abinash18/KBUltra/ControlCardRP/Hardware/Rev1/ControlCardRP/_restore_backup_2026-08-10T23-14-51-235/Production/ordering_instructions.txt

Ordering Instructions:
Panel dimensions: 68.10 x 63.14 mm.
Solder Mask: Red (Default)
Silkscreen: White (Default)
Layers: 4
Finish: HASL Lead-free (Default)
Thickness: 1.6mm (Default)
Copper weight: 1oz (Default)
Minimum track width: 0.12mm (4.72mil)
Minimum via drill: 0.20mm (7.87mil)
