abinash18/KBUltra/Hardware/PCB/Mk1/Rev1/KBUltraMk1/KBUltraMk1.kicad_pcb

## KiCad design Hardware/PCB/Mk1/Rev1/KBUltraMk1/KBUltraMk1.kicad_pcb (2026-09-08)

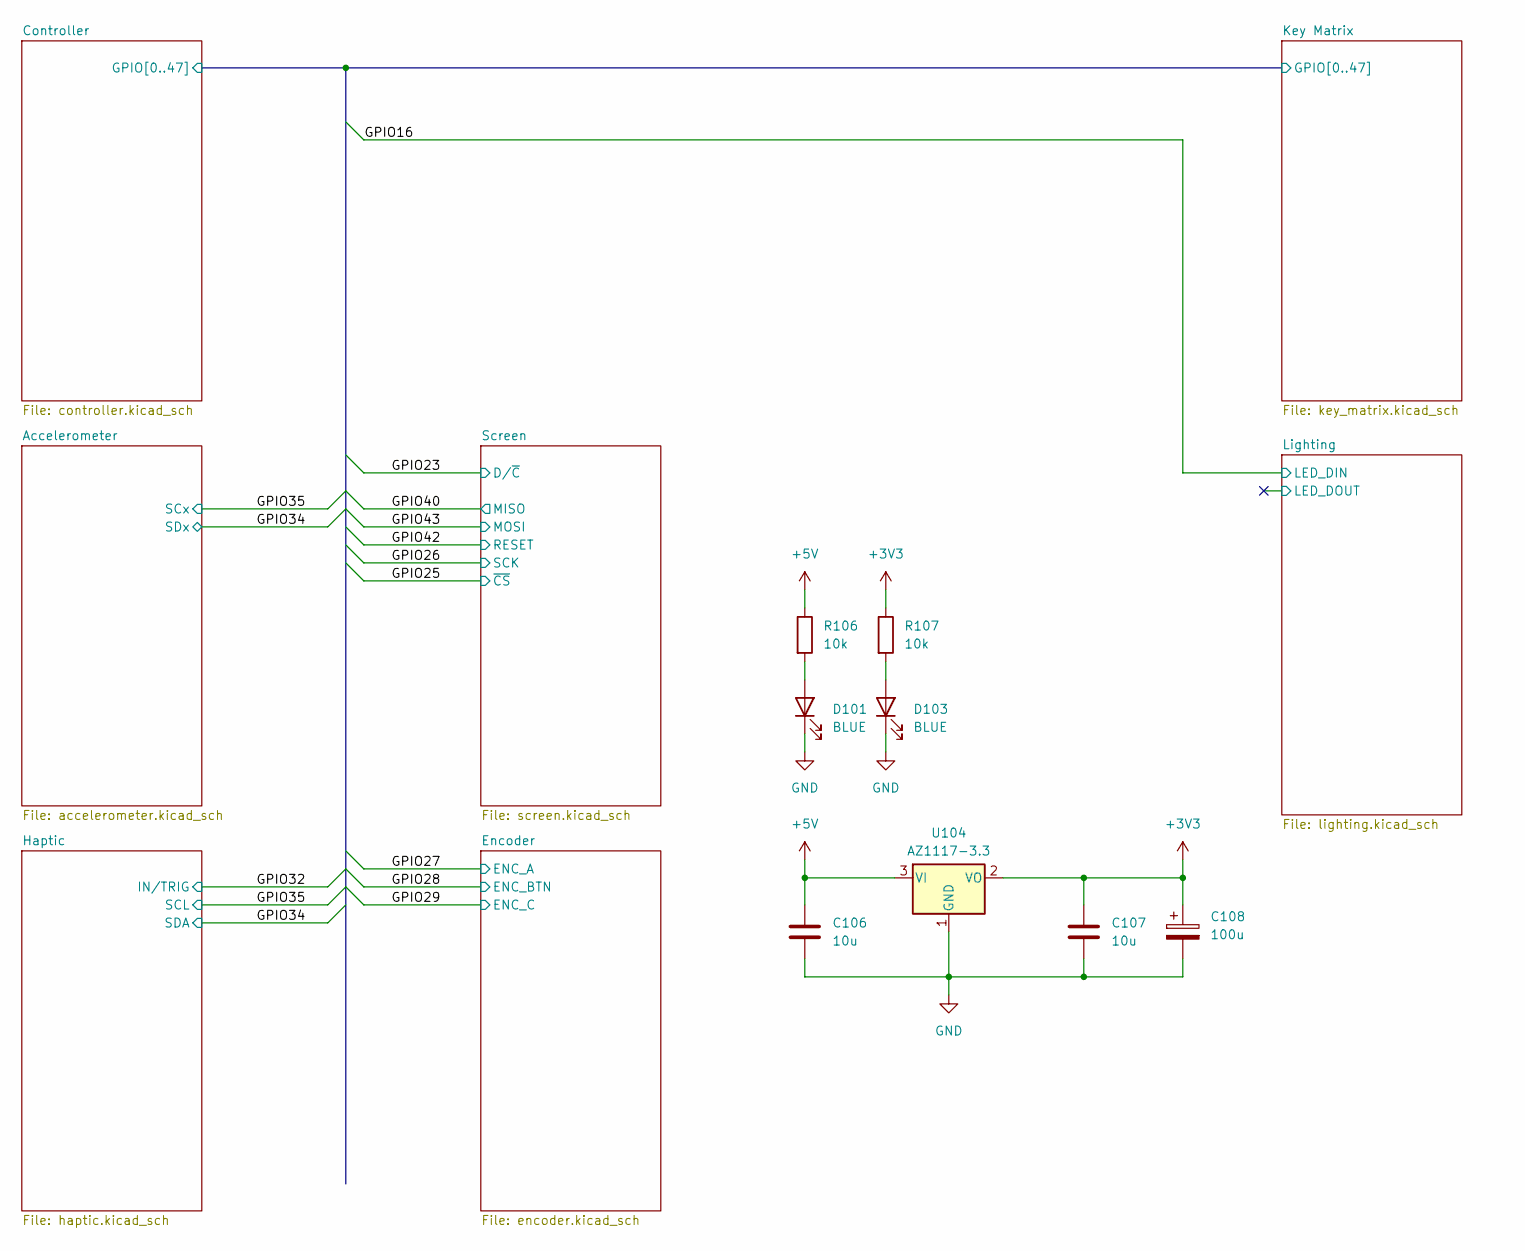
[picture p1: schematic KBUltraMk1.kicad_sch]

Parts:
C106, C107: 10u; C_0603_1608Metric; JLC Part# C96446
C108: 100u; CP_EIA-3528-21_Kemet-B_HandSolder; JLC Part# C16133
D101, D103: BLUE; LED_0603_1608Metric
R106, R107: 10k; R_0603_1608Metric; JLC Part# C25804
U104: AZ1117-3.3; SOT-223-3_TabPin2

Connections:
+3V3: C107.2, C108.1, R107.1, U104.2 (VO); also elsewhere on the board
+5V: C106.2, R106.1, U104.3 (VI); also elsewhere on the board
GND: C106.1, C107.1, C108.2, D101.1 (K), D103.1 (K), U104.1 (GND); also elsewhere on the board
unnamed: D101.2 (A), R106.2
unnamed: D103.2 (A), R107.2

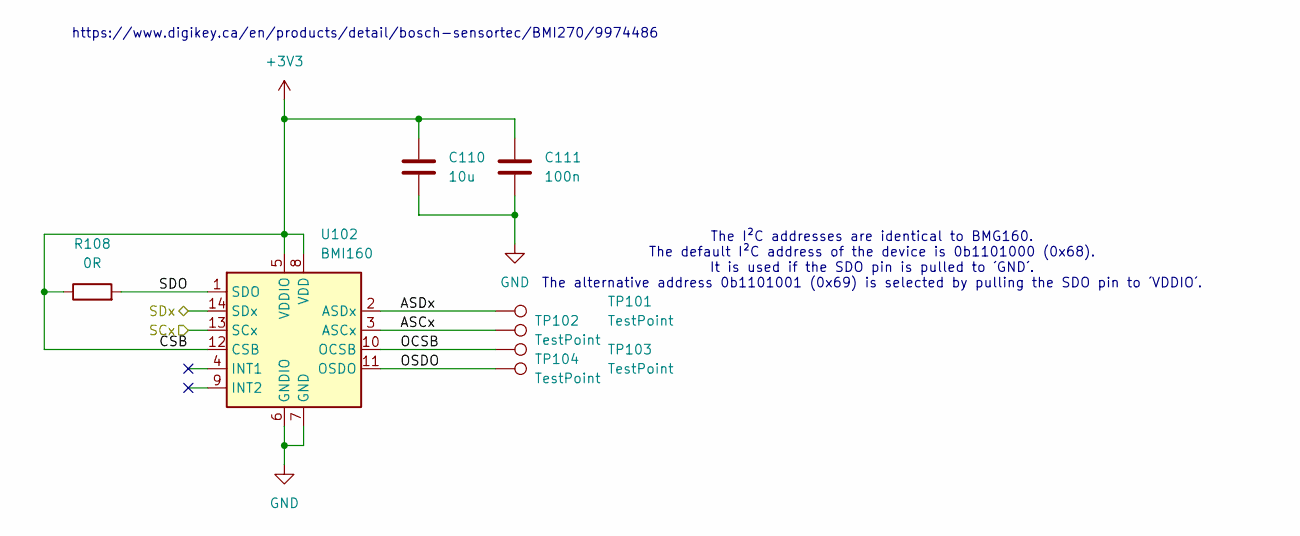
[picture p2: schematic accelerometer.kicad_sch]

Parts:
C110: 10u; C_0603_1608Metric; JLC Part# C96446
C111: 100n; C_0603_1608Metric; JLC Part# C14663
R108: 0R; R_0603_1608Metric; JLC Part# C21189
TP101, TP102, TP103, TP104: TestPoint; TestPoint_Pad_D1.0mm
U102: BMI160; Bosch_LGA-14_3x2.5mm_P0.5mm

Connections:
+3V3: C110.1, C111.1, R108.1, U102.5 (VDDIO), U102.8 (VDD), U102.12 (CSB); also elsewhere on the board
/Accelerometer/ASCx: TP102.1 (1_1), U102.3 (ASCx)
/Accelerometer/ASDx: TP101.1 (1_1), U102.2 (ASDx)
/Accelerometer/OCSB: TP103.1 (1_1), U102.10 (OCSB)
/Accelerometer/OSDO: TP104.1 (1_1), U102.11 (OSDO)
/Accelerometer/SDO: R108.2, U102.1 (SDO)
/Controller/GPIO34: U102.14 (SDx); also elsewhere on the board
/Controller/GPIO35: U102.13 (SCx); also elsewhere on the board
GND: C110.2, C111.2, U102.6 (GNDIO), U102.7 (GND); also elsewhere on the board

Notes on the sheet:
The I²C addresses are identical to BMG160. The default I²C address of the device is 0b1101000 (0x68). It is used if the SDO pin is pulled to ´GND´. The alternative address 0b1101001 (0x69) is selected by pulling the SDO pin to ´VDDIO´.
https://www.digikey.ca/en/products/detail/bosch-sensortec/BMI270/9974486

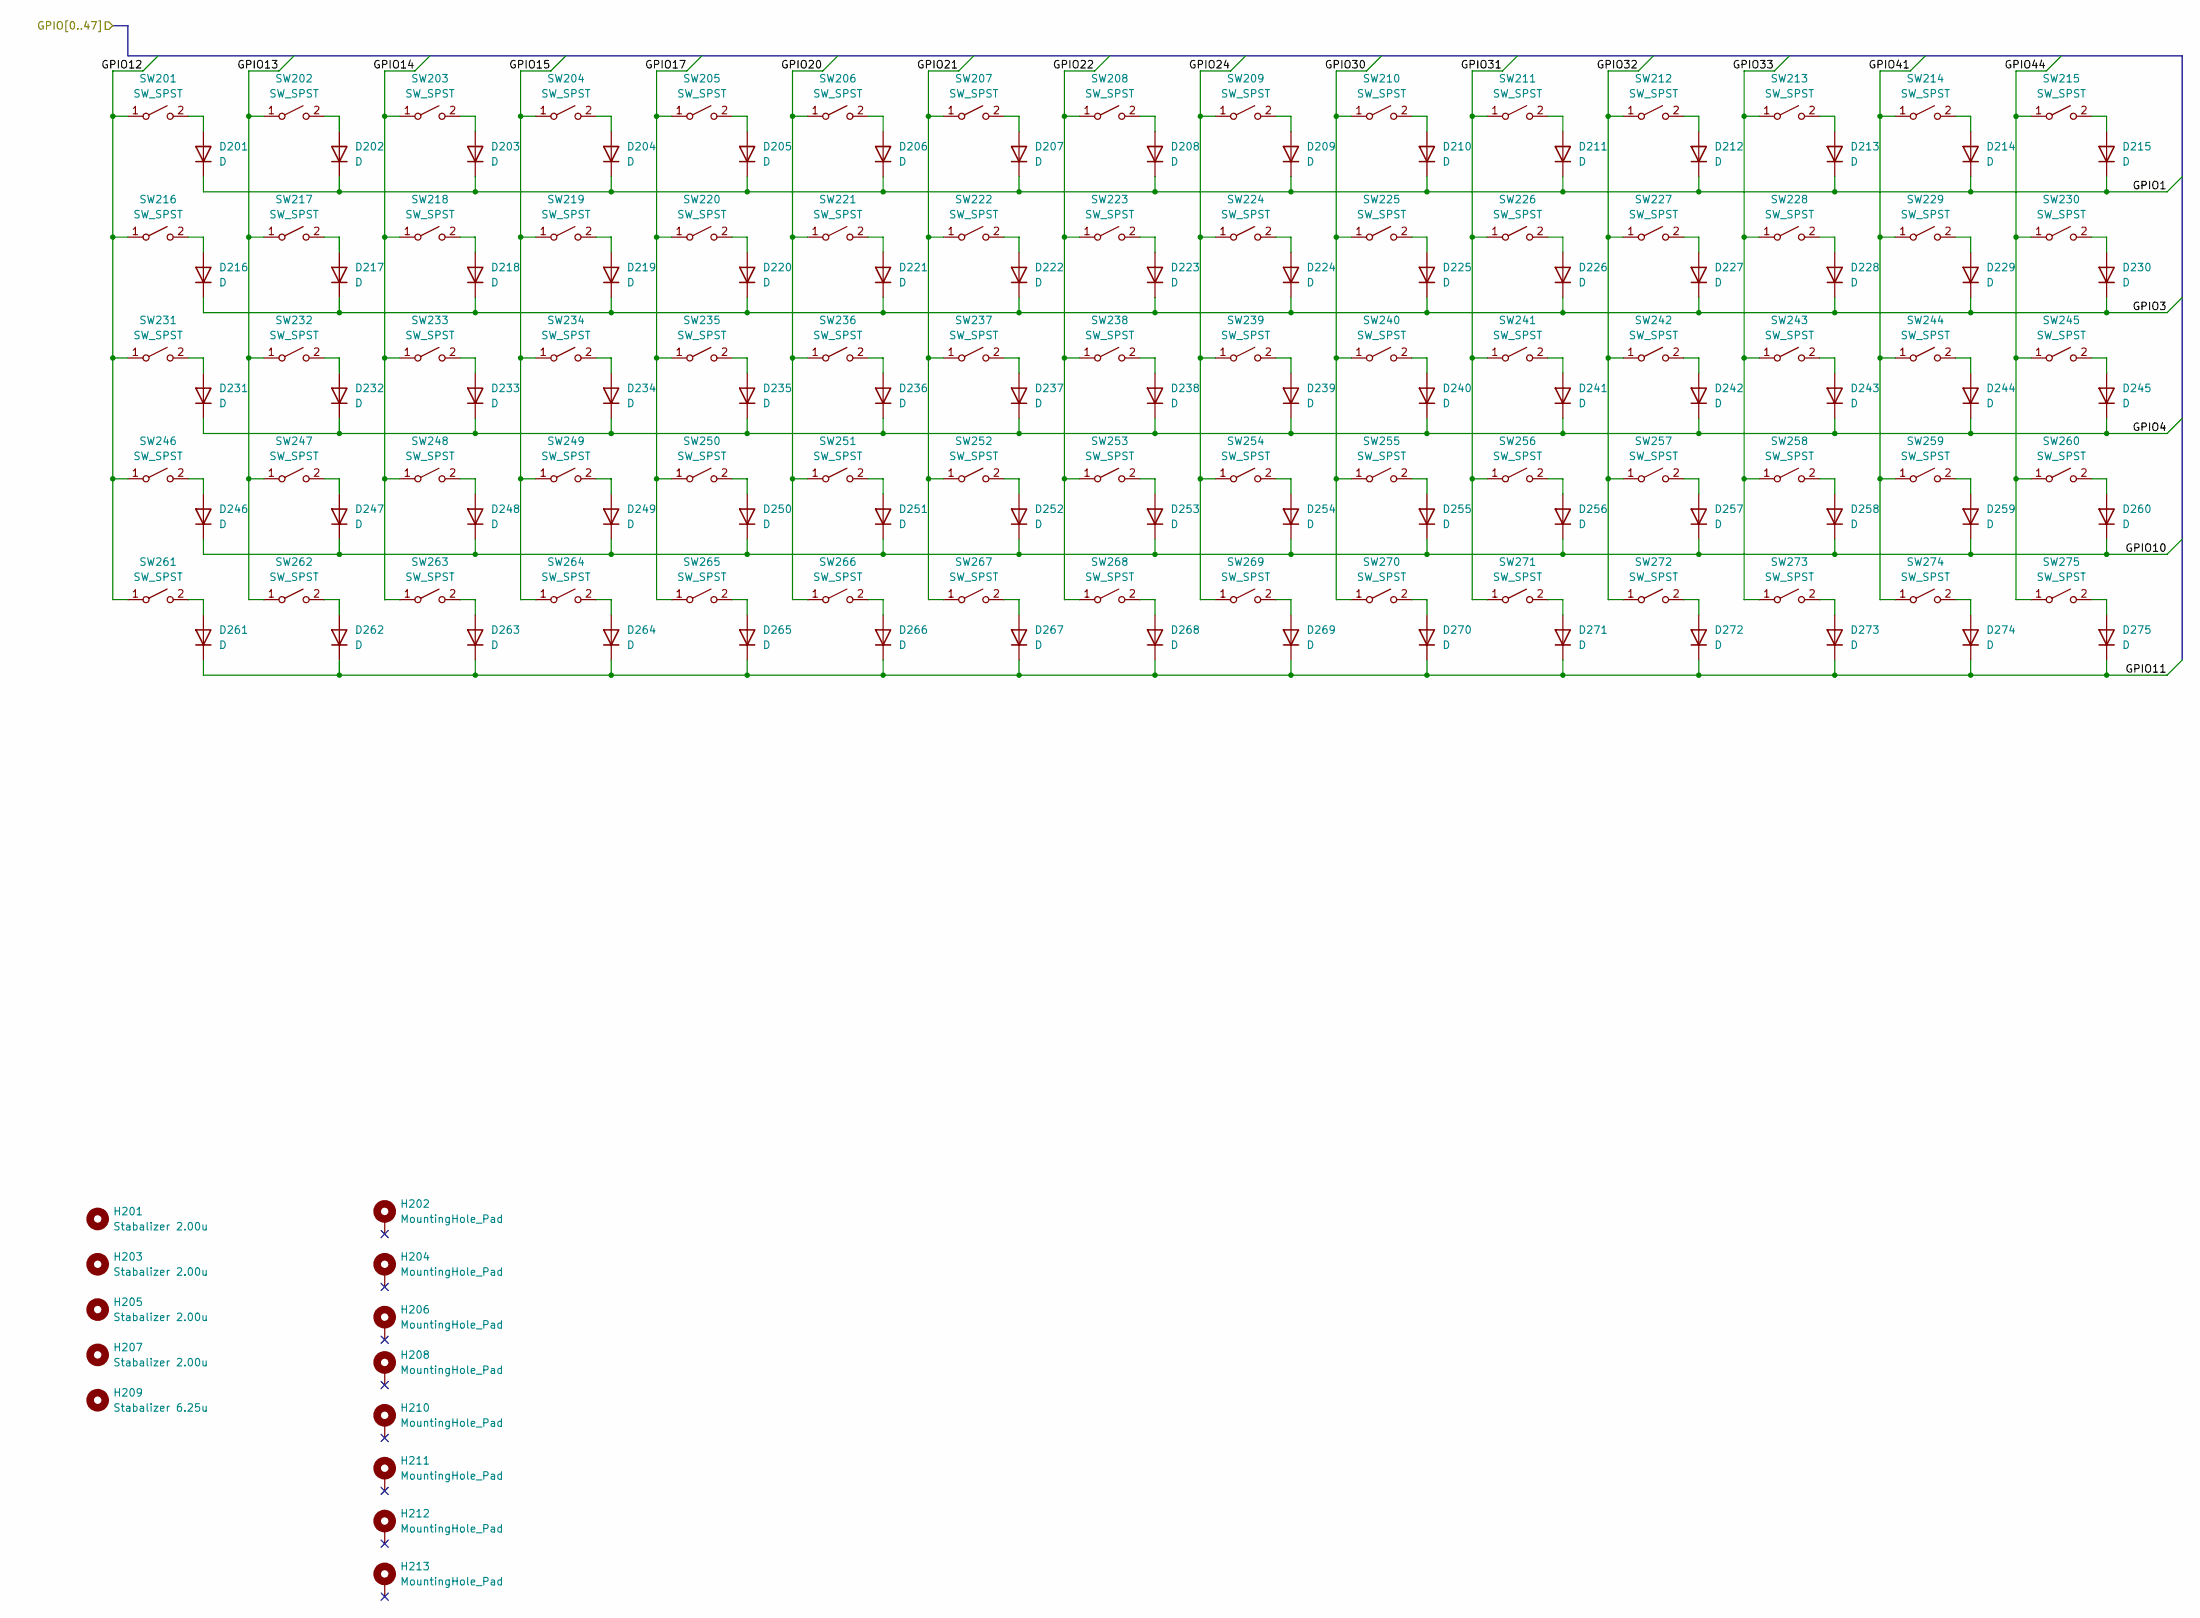
[picture p3: schematic key_matrix.kicad_sch]

Parts:
D201, D202, D203, D204, D205, D206, D207, D208, D209, D210, D211, D212, D213, D214, D215, D216, D217, D218, D219, D220, D221, D222, D223, D224, D225, D226, D227, D228, D229, D230, D231, D232, D233, D234, D235, D236, D237, D238, D239, D240, D241, D242, D243, D244, D245, D246, D247, D248, D249, D250, D251, D252, D253, D254, D255, D256, D257, D258, D259, D260, D261, D262, D263, D264, D265, D266, D267, D268, D269, D270, D271, D272, D273, D274, D275: D; D_SOD-123; JLC Part# C81598
H201, H203, H205, H207: Stabalizer 2.00u; Stabilizer_Cherry_MX_2.00u
H202, H204, H206, H208, H210, H211, H212, H213: MountingHole_Pad; MountingHole_3.2mm_M3_Pad_Via
H209: Stabalizer 6.25u; Stabilizer_Cherry_MX_6.25u
SW201, SW202, SW203, SW204, SW205, SW206, SW207, SW208, SW209, SW210, SW211, SW212, SW213, SW214, SW215, SW216, SW217, SW218, SW219, SW220, SW221, SW222, SW223, SW224, SW226, SW228, SW229, SW230, SW231, SW232, SW233, SW234, SW235, SW236, SW237, SW238, SW239, SW241, SW243, SW244, SW245, SW246, SW247, SW248, SW249, SW250, SW251, SW252, SW253, SW255, SW257, SW258, SW259, SW260, SW261, SW262, SW263, SW264, SW265, SW266: SW_SPST; SW_Hotswap_Kailh_MX_Plated_1.00u; JLC Part# C41430893
SW225: SW_SPST; SW_Hotswap_Kailh_MX_Plated_2.00u; JLC Part# C41430893
SW227, SW240: SW_SPST; SW_Hotswap_Kailh_MX_Plated_1.50u; JLC Part# C41430893
SW242: SW_SPST; SW_Hotswap_Kailh_MX_Plated_1.75u; JLC Part# C41430893
SW254, SW256: SW_SPST; SW_Hotswap_Kailh_MX_Plated_2.25u; JLC Part# C41430893
SW267: SW_SPST; SW_Hotswap_Kailh_MX_Plated_2.75u; JLC Part# C41430893
SW268, SW269, SW270, SW272, SW273, SW274, SW275: SW_SPST; SW_Hotswap_Kailh_MX_Plated_1.25u; JLC Part# C41430893
SW271: SW_SPST; SW_Hotswap_Kailh_MX_Plated_6.25u; JLC Part# C41430893

Connections:
/Controller/GPIO1: D201.1 (K), D202.1 (K), D203.1 (K), D204.1 (K), D205.1 (K), D206.1 (K), D207.1 (K), D208.1 (K), D209.1 (K), D210.1 (K), D211.1 (K), D212.1 (K), D213.1 (K), D214.1 (K), D215.1 (K); also elsewhere on the board
/Controller/GPIO3: D216.1 (K), D217.1 (K), D218.1 (K), D219.1 (K), D220.1 (K), D221.1 (K), D222.1 (K), D223.1 (K), D224.1 (K), D225.1 (K), D226.1 (K), D227.1 (K), D228.1 (K), D229.1 (K), D230.1 (K); also elsewhere on the board
/Controller/GPIO4: D231.1 (K), D232.1 (K), D233.1 (K), D234.1 (K), D235.1 (K), D236.1 (K), D237.1 (K), D238.1 (K), D239.1 (K), D240.1 (K), D241.1 (K), D242.1 (K), D243.1 (K), D244.1 (K), D245.1 (K); also elsewhere on the board
/Controller/GPIO10: D246.1 (K), D247.1 (K), D248.1 (K), D249.1 (K), D250.1 (K), D251.1 (K), D252.1 (K), D253.1 (K), D254.1 (K), D255.1 (K), D256.1 (K), D257.1 (K), D258.1 (K), D259.1 (K), D260.1 (K); also elsewhere on the board
/Controller/GPIO11: D261.1 (K), D262.1 (K), D263.1 (K), D264.1 (K), D265.1 (K), D266.1 (K), D267.1 (K), D268.1 (K), D269.1 (K), D270.1 (K), D271.1 (K), D272.1 (K), D273.1 (K), D274.1 (K), D275.1 (K); also elsewhere on the board
/Controller/GPIO12: SW201.1 (A), SW216.1 (A), SW231.1 (A), SW246.1 (A), SW261.1 (A); also elsewhere on the board
/Controller/GPIO13: SW202.1 (A), SW217.1 (A), SW232.1 (A), SW247.1 (A), SW262.1 (A); also elsewhere on the board
/Controller/GPIO14: SW203.1 (A), SW218.1 (A), SW233.1 (A), SW248.1 (A), SW263.1 (A); also elsewhere on the board
/Controller/GPIO15: SW204.1 (A), SW219.1 (A), SW234.1 (A), SW249.1 (A), SW264.1 (A); also elsewhere on the board
/Controller/GPIO17: SW205.1 (A), SW220.1 (A), SW235.1 (A), SW250.1 (A), SW265.1 (A); also elsewhere on the board
/Controller/GPIO20: SW206.1 (A), SW221.1 (A), SW236.1 (A), SW251.1 (A), SW266.1 (A); also elsewhere on the board
/Controller/GPIO21: SW207.1 (A), SW222.1 (A), SW237.1 (A), SW252.1 (A), SW267.1 (A); also elsewhere on the board
/Controller/GPIO22: SW208.1 (A), SW223.1 (A), SW238.1 (A), SW253.1 (A), SW268.1 (A); also elsewhere on the board
/Controller/GPIO24: SW209.1 (A), SW224.1 (A), SW239.1 (A), SW254.1 (A), SW269.1 (A); also elsewhere on the board
/Controller/GPIO30: SW210.1 (A), SW225.1 (A), SW240.1 (A), SW255.1 (A), SW270.1 (A); also elsewhere on the board
/Controller/GPIO31: SW211.1 (A), SW226.1 (A), SW241.1 (A), SW256.1 (A), SW271.1 (A); also elsewhere on the board
/Controller/GPIO32: SW212.1 (A), SW227.1 (A), SW242.1 (A), SW257.1 (A), SW272.1 (A); also elsewhere on the board
/Controller/GPIO33: SW213.1 (A), SW228.1 (A), SW243.1 (A), SW258.1 (A), SW273.1 (A); also elsewhere on the board
/Controller/GPIO41: SW214.1 (A), SW229.1 (A), SW244.1 (A), SW259.1 (A), SW274.1 (A); also elsewhere on the board
/Controller/GPIO44: SW215.1 (A), SW230.1 (A), SW245.1 (A), SW260.1 (A), SW275.1 (A); also elsewhere on the board
unnamed: D201.2 (A), SW201.2 (B)
unnamed: D202.2 (A), SW202.2 (B)
unnamed: D203.2 (A), SW203.2 (B)
unnamed: D204.2 (A), SW204.2 (B)
unnamed: D205.2 (A), SW205.2 (B)
unnamed: D206.2 (A), SW206.2 (B)
unnamed: D207.2 (A), SW207.2 (B)
unnamed: D208.2 (A), SW208.2 (B)
unnamed: D209.2 (A), SW209.2 (B)
unnamed: D210.2 (A), SW210.2 (B)
unnamed: D211.2 (A), SW211.2 (B)
unnamed: D212.2 (A), SW212.2 (B)
unnamed: D213.2 (A), SW213.2 (B)
unnamed: D214.2 (A), SW214.2 (B)
unnamed: D215.2 (A), SW215.2 (B)
unnamed: D216.2 (A), SW216.2 (B)
unnamed: D217.2 (A), SW217.2 (B)
unnamed: D218.2 (A), SW218.2 (B)
unnamed: D219.2 (A), SW219.2 (B)
unnamed: D220.2 (A), SW220.2 (B)
unnamed: D221.2 (A), SW221.2 (B)
unnamed: D222.2 (A), SW222.2 (B)
unnamed: D223.2 (A), SW223.2 (B)
unnamed: D224.2 (A), SW224.2 (B)
unnamed: D225.2 (A), SW225.2 (B)
unnamed: D226.2 (A), SW226.2 (B)
unnamed: D227.2 (A), SW227.2 (B)
unnamed: D228.2 (A), SW228.2 (B)
unnamed: D229.2 (A), SW229.2 (B)
unnamed: D230.2 (A), SW230.2 (B)
unnamed: D231.2 (A), SW231.2 (B)
unnamed: D232.2 (A), SW232.2 (B)
unnamed: D233.2 (A), SW233.2 (B)
unnamed: D234.2 (A), SW234.2 (B)
unnamed: D235.2 (A), SW235.2 (B)
unnamed: D236.2 (A), SW236.2 (B)
unnamed: D237.2 (A), SW237.2 (B)
unnamed: D238.2 (A), SW238.2 (B)
unnamed: D239.2 (A), SW239.2 (B)
unnamed: D240.2 (A), SW240.2 (B)
unnamed: D241.2 (A), SW241.2 (B)
unnamed: D242.2 (A), SW242.2 (B)
unnamed: D243.2 (A), SW243.2 (B)
unnamed: D244.2 (A), SW244.2 (B)
unnamed: D245.2 (A), SW245.2 (B)
unnamed: D246.2 (A), SW246.2 (B)
unnamed: D247.2 (A), SW247.2 (B)
unnamed: D248.2 (A), SW248.2 (B)
unnamed: D249.2 (A), SW249.2 (B)
unnamed: D250.2 (A), SW250.2 (B)
unnamed: D251.2 (A), SW251.2 (B)
unnamed: D252.2 (A), SW252.2 (B)
unnamed: D253.2 (A), SW253.2 (B)
unnamed: D254.2 (A), SW254.2 (B)
unnamed: D255.2 (A), SW255.2 (B)
unnamed: D256.2 (A), SW256.2 (B)
unnamed: D257.2 (A), SW257.2 (B)
unnamed: D258.2 (A), SW258.2 (B)
unnamed: D259.2 (A), SW259.2 (B)
unnamed: D260.2 (A), SW260.2 (B)
unnamed: D261.2 (A), SW261.2 (B)
unnamed: D262.2 (A), SW262.2 (B)
unnamed: D263.2 (A), SW263.2 (B)
unnamed: D264.2 (A), SW264.2 (B)
unnamed: D265.2 (A), SW265.2 (B)
unnamed: D266.2 (A), SW266.2 (B)
unnamed: D267.2 (A), SW267.2 (B)
unnamed: D268.2 (A), SW268.2 (B)
unnamed: D269.2 (A), SW269.2 (B)
unnamed: D270.2 (A), SW270.2 (B)
unnamed: D271.2 (A), SW271.2 (B)
unnamed: D272.2 (A), SW272.2 (B)
unnamed: D273.2 (A), SW273.2 (B)
unnamed: D274.2 (A), SW274.2 (B)
unnamed: D275.2 (A), SW275.2 (B)

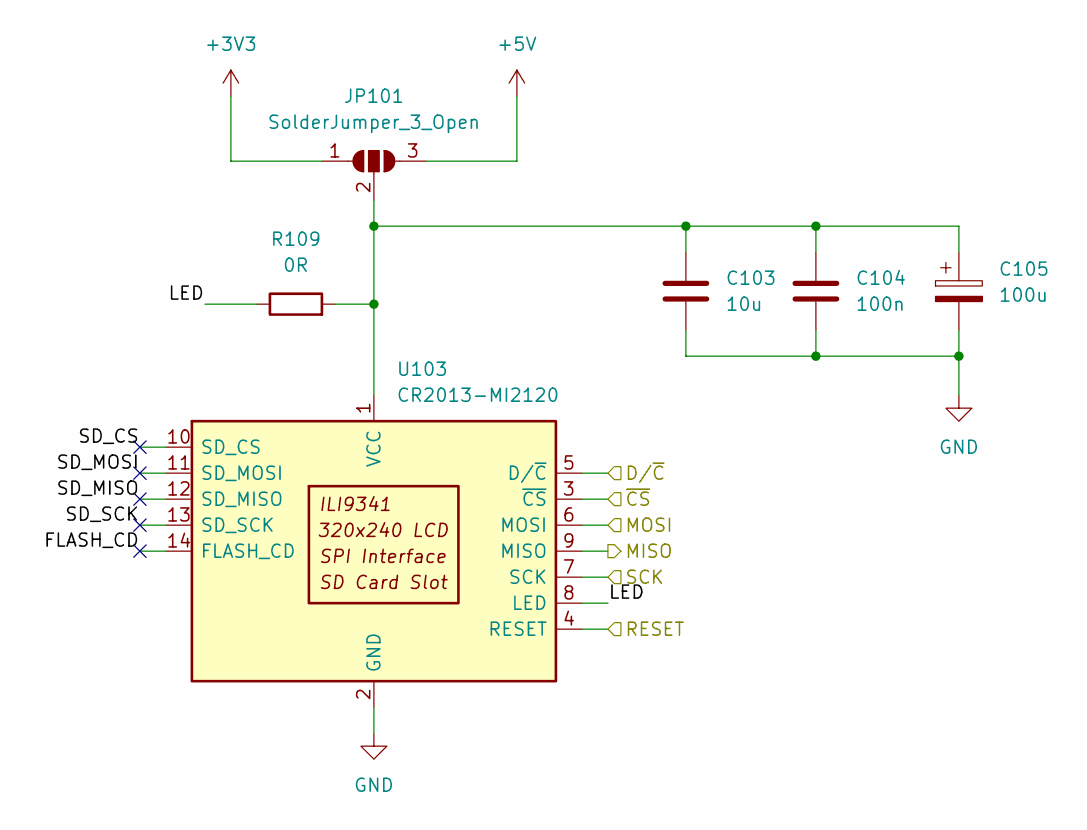
[picture p4: schematic screen.kicad_sch]

Parts:
C103: 10u; C_0603_1608Metric; JLC Part# C96446
C104: 100n; C_0603_1608Metric; JLC Part# C14663
C105: 100u; CP_EIA-3528-21_Kemet-B_HandSolder; JLC Part# C16133
JP101: SolderJumper_3_Open; SolderJumper-3_P2.0mm_Open_TrianglePad1.0x1.5mm_NumberLabels
R109: 0R; R_0603_1608Metric; JLC Part# C21189
U103: CR2013-MI2120

Connections:
+3V3: JP101.1 (A); also elsewhere on the board
+5V: JP101.3 (B); also elsewhere on the board
/Controller/GPIO23: U103.5 (D/~C); also elsewhere on the board
/Controller/GPIO25: U103.3 (~CS); also elsewhere on the board
/Controller/GPIO26: U103.7 (SCK); also elsewhere on the board
/Controller/GPIO40: U103.9 (MISO); also elsewhere on the board
/Controller/GPIO42: U103.4 (RESET); also elsewhere on the board
/Controller/GPIO43: U103.6 (MOSI); also elsewhere on the board
/Screen/LED: R109.1, U103.8 (LED)
GND: C103.2, C104.2, C105.2, U103.2 (GND); also elsewhere on the board
unnamed: C103.1, C104.1, C105.1, JP101.2 (C), R109.2, U103.1 (VCC)

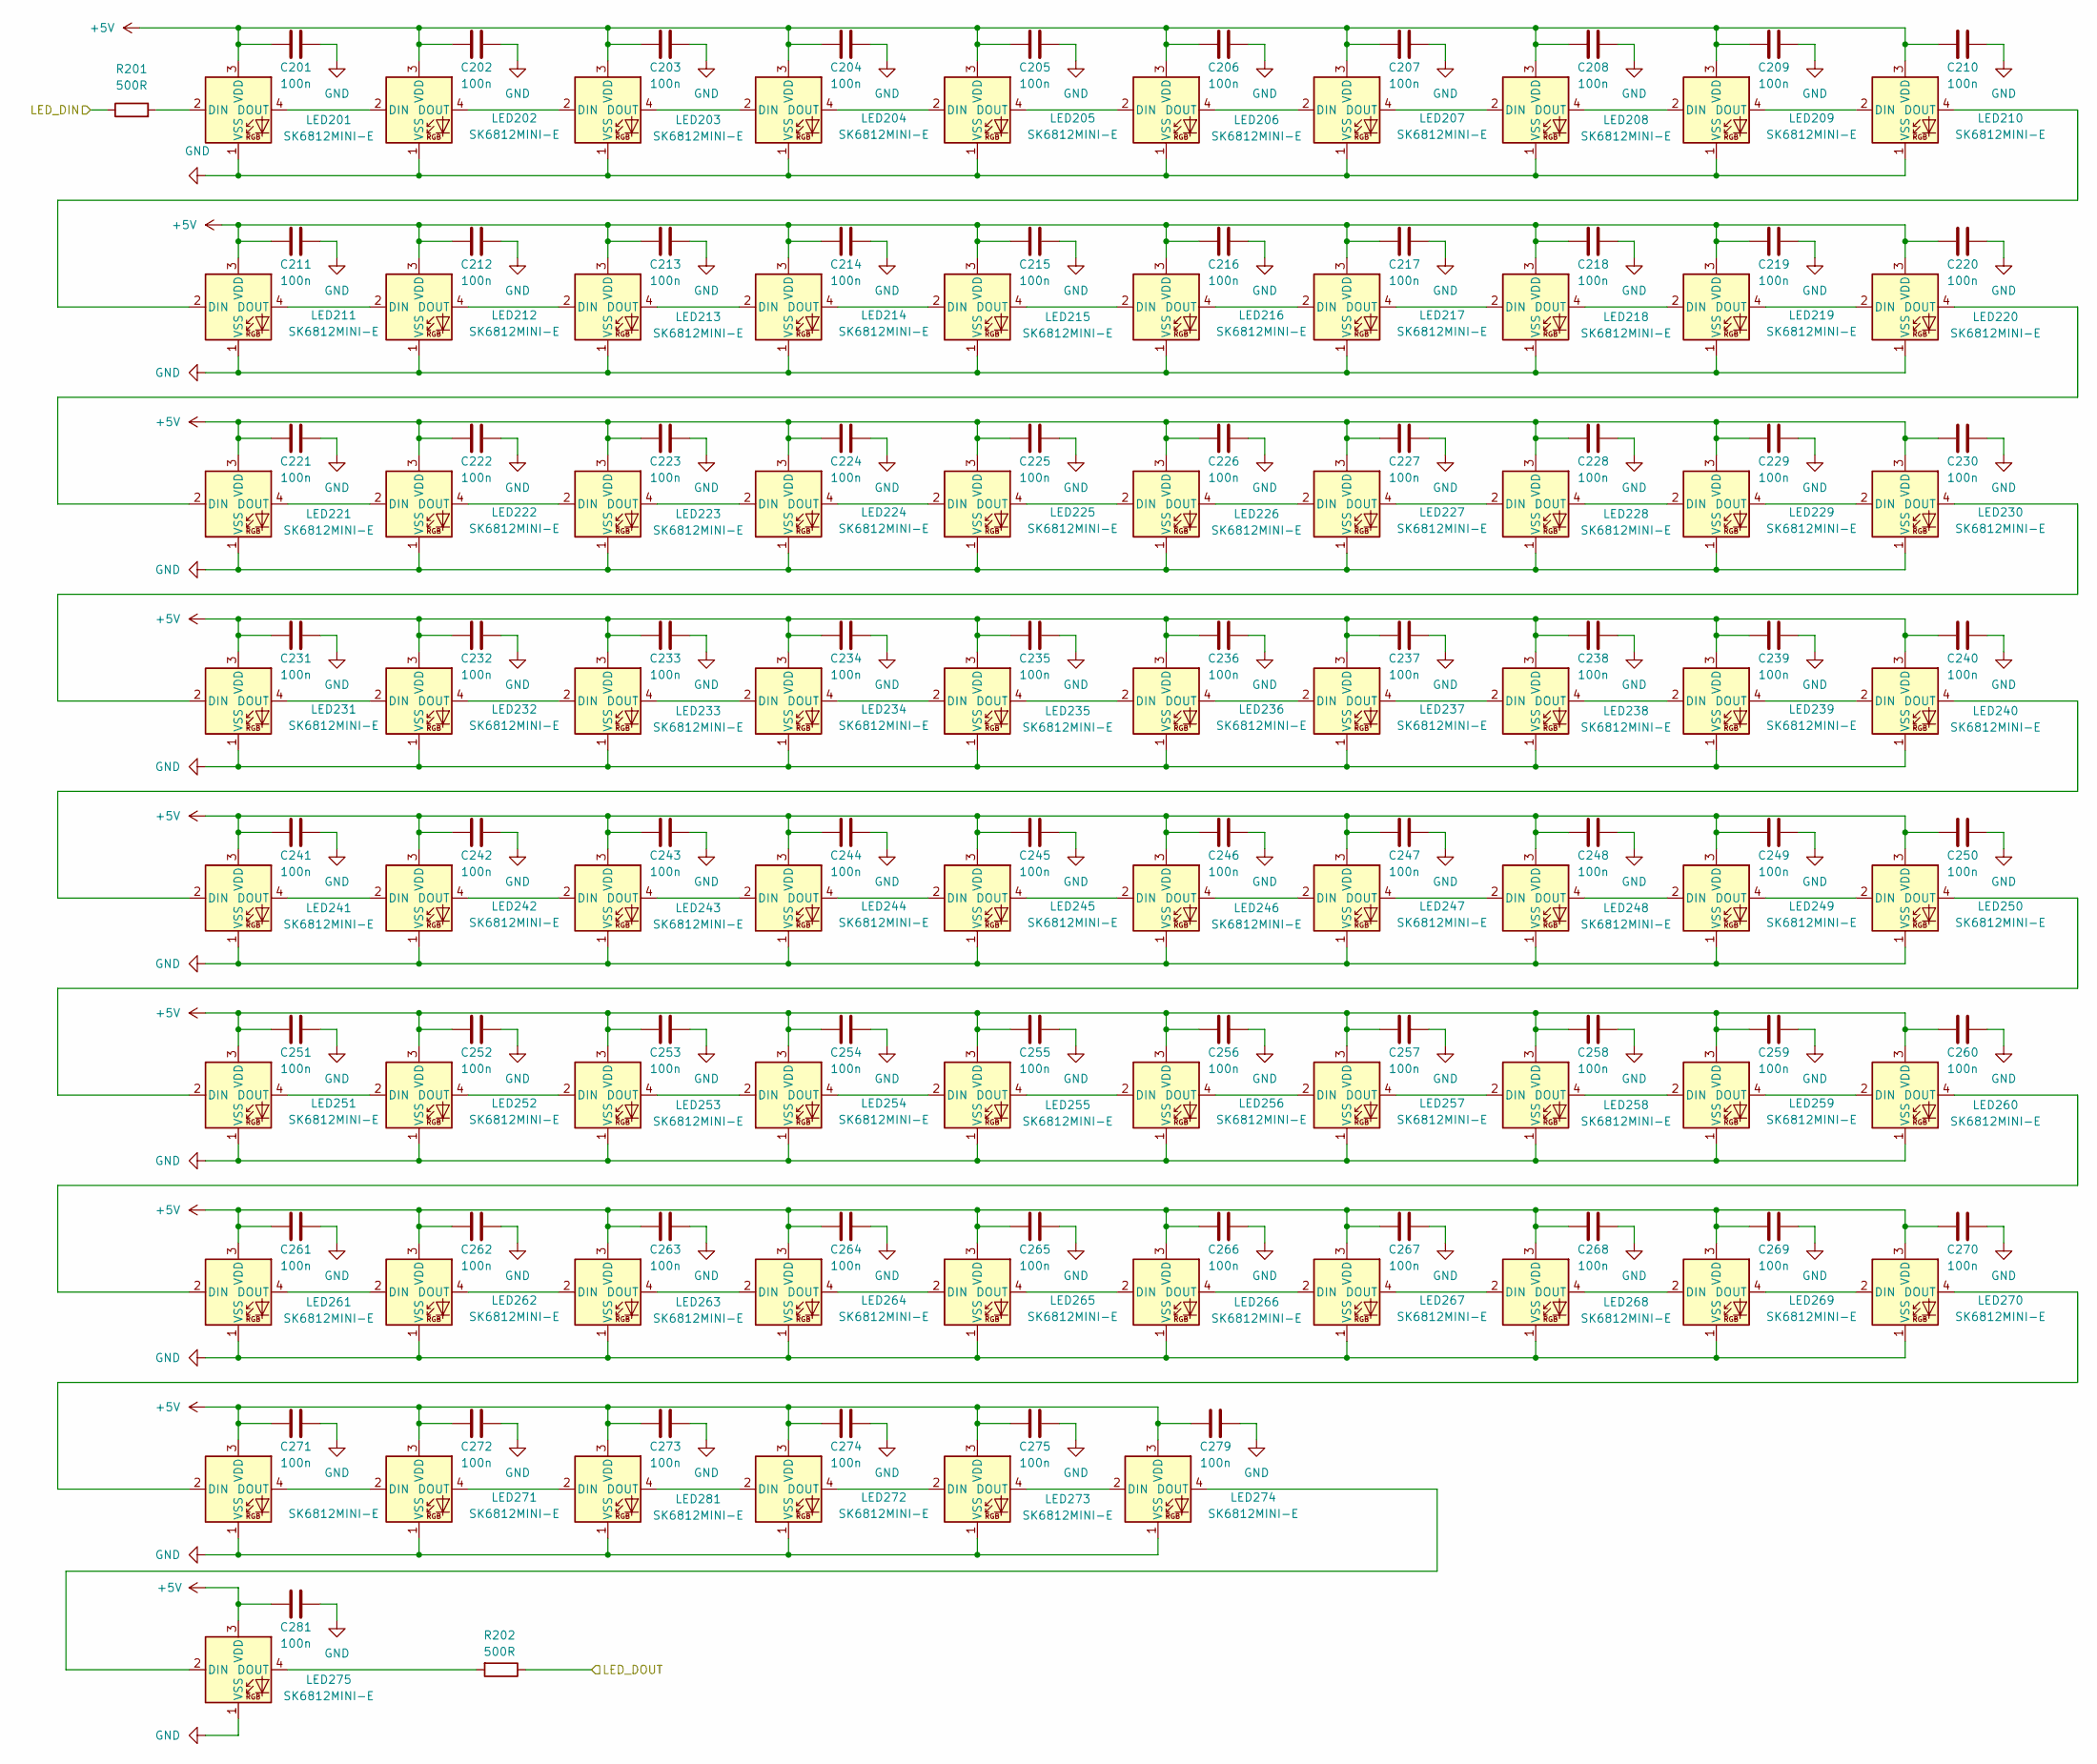
[picture p5: schematic lighting.kicad_sch]

Parts:
C201, C202, C203, C204, C205, C206, C207, C208, C209, C210, C211, C212, C213, C214, C215, C216, C217, C218, C219, C220, C221, C222, C223, C224, C225, C226, C227, C228, C229, C230, C231, C232, C233, C234, C235, C236, C237, C238, C239, C240, C241, C242, C243, C244, C245, C246, C247, C248, C249, C250, C251, C252, C253, C254, C255, C256, C257, C258, C259, C260, C261, C262, C263, C264, C265, C266, C267, C268, C269, C270, C271, C272, C273, C274, C275, C279, C281: 100n; C_0603_1608Metric; JLC Part# C14663
LED201, LED202, LED203, LED204, LED205, LED206, LED207, LED208, LED209, LED210, LED211, LED212, LED213, LED214, LED215, LED216, LED217, LED218, LED219, LED220, LED221, LED222, LED223, LED224, LED225, LED226, LED227, LED228, LED229, LED230, LED231, LED232, LED233, LED234, LED235, LED236, LED237, LED238, LED239, LED240, LED241, LED242, LED243, LED244, LED245, LED246, LED247, LED248, LED249, LED250, LED251, LED252, LED253, LED254, LED255, LED256, LED257, LED258, LED259, LED260, LED261, LED262, LED263, LED264, LED265, LED266, LED267, LED268, LED269, LED270, LED271, LED272, LED273, LED274, LED275, LED279, LED281: SK6812MINI-E; LED_SK6812MINI-E_3.2x2.8mm_P1.5mm_ReverseMount
R201, R202: 500R; R_0603_1608Metric; JLC Part# C23193

Connections:
+5V: C201.1, C202.1, C203.1, C204.1, C205.1, C206.1, C207.1, C208.1, C209.1, C210.1, C211.1, C212.1, C213.1, C214.1, C215.1, C216.1, C217.1, C218.1, C219.1, C220.1, C221.1, C222.1, C223.1, C224.1, C225.1, C226.1, C227.1, C228.1, C229.1, C230.1, C231.1, C232.1, C233.1, C234.1, C235.1, C236.1, C237.1, C238.1, C239.1, C240.1, C241.1, C242.1, C243.1, C244.1, C245.1, C246.1, C247.1, C248.1, C249.1, C250.1, C251.1, C252.1, C253.1, C254.1, C255.1, C256.1, C257.1, C258.1, C259.1, C260.1, C261.1, C262.1, C263.1, C264.1, C265.1, C266.1, C267.1, C268.1, C269.1, C270.1, C271.1, C272.1, C273.1, C274.1, C275.1, C279.1, C281.1, LED201.3 (VDD), LED202.3 (VDD), LED203.3 (VDD), LED204.3 (VDD), LED205.3 (VDD), LED206.3 (VDD), LED207.3 (VDD), LED208.3 (VDD), LED209.3 (VDD), LED210.3 (VDD), LED211.3 (VDD), LED212.3 (VDD), LED213.3 (VDD), LED214.3 (VDD), LED215.3 (VDD), LED216.3 (VDD), LED217.3 (VDD), LED218.3 (VDD), LED219.3 (VDD), LED220.3 (VDD), LED221.3 (VDD), LED222.3 (VDD), LED223.3 (VDD), LED224.3 (VDD), LED225.3 (VDD), LED226.3 (VDD), LED227.3 (VDD), LED228.3 (VDD), LED229.3 (VDD), LED230.3 (VDD), LED231.3 (VDD), LED232.3 (VDD), LED233.3 (VDD), LED234.3 (VDD), LED235.3 (VDD), LED236.3 (VDD), LED237.3 (VDD), LED238.3 (VDD), LED239.3 (VDD), LED240.3 (VDD), LED241.3 (VDD), LED242.3 (VDD), LED243.3 (VDD), LED244.3 (VDD), LED245.3 (VDD), LED246.3 (VDD), LED247.3 (VDD), LED248.3 (VDD), LED249.3 (VDD), LED250.3 (VDD), LED251.3 (VDD), LED252.3 (VDD), LED253.3 (VDD), LED254.3 (VDD), LED255.3 (VDD), LED256.3 (VDD), LED257.3 (VDD), LED258.3 (VDD), LED259.3 (VDD), LED260.3 (VDD), LED261.3 (VDD), LED262.3 (VDD), LED263.3 (VDD), LED264.3 (VDD), LED265.3 (VDD), LED266.3 (VDD), LED267.3 (VDD), LED268.3 (VDD), LED269.3 (VDD), LED270.3 (VDD), LED271.3 (VDD), LED272.3 (VDD), LED273.3 (VDD), LED274.3 (VDD), LED275.3 (VDD), LED279.3 (VDD), LED281.3 (VDD); also elsewhere on the board
/Controller/GPIO16: R201.1; also elsewhere on the board
/Lighting/LED_DOUT: R202.1
GND: C201.2, C202.2, C203.2, C204.2, C205.2, C206.2, C207.2, C208.2, C209.2, C210.2, C211.2, C212.2, C213.2, C214.2, C215.2, C216.2, C217.2, C218.2, C219.2, C220.2, C221.2, C222.2, C223.2, C224.2, C225.2, C226.2, C227.2, C228.2, C229.2, C230.2, C231.2, C232.2, C233.2, C234.2, C235.2, C236.2, C237.2, C238.2, C239.2, C240.2, C241.2, C242.2, C243.2, C244.2, C245.2, C246.2, C247.2, C248.2, C249.2, C250.2, C251.2, C252.2, C253.2, C254.2, C255.2, C256.2, C257.2, C258.2, C259.2, C260.2, C261.2, C262.2, C263.2, C264.2, C265.2, C266.2, C267.2, C268.2, C269.2, C270.2, C271.2, C272.2, C273.2, C274.2, C275.2, C279.2, C281.2, LED201.1 (VSS), LED202.1 (VSS), LED203.1 (VSS), LED204.1 (VSS), LED205.1 (VSS), LED206.1 (VSS), LED207.1 (VSS), LED208.1 (VSS), LED209.1 (VSS), LED210.1 (VSS), LED211.1 (VSS), LED212.1 (VSS), LED213.1 (VSS), LED214.1 (VSS), LED215.1 (VSS), LED216.1 (VSS), LED217.1 (VSS), LED218.1 (VSS), LED219.1 (VSS), LED220.1 (VSS), LED221.1 (VSS), LED222.1 (VSS), LED223.1 (VSS), LED224.1 (VSS), LED225.1 (VSS), LED226.1 (VSS), LED227.1 (VSS), LED228.1 (VSS), LED229.1 (VSS), LED230.1 (VSS), LED231.1 (VSS), LED232.1 (VSS), LED233.1 (VSS), LED234.1 (VSS), LED235.1 (VSS), LED236.1 (VSS), LED237.1 (VSS), LED238.1 (VSS), LED239.1 (VSS), LED240.1 (VSS), LED241.1 (VSS), LED242.1 (VSS), LED243.1 (VSS), LED244.1 (VSS), LED245.1 (VSS), LED246.1 (VSS), LED247.1 (VSS), LED248.1 (VSS), LED249.1 (VSS), LED250.1 (VSS), LED251.1 (VSS), LED252.1 (VSS), LED253.1 (VSS), LED254.1 (VSS), LED255.1 (VSS), LED256.1 (VSS), LED257.1 (VSS), LED258.1 (VSS), LED259.1 (VSS), LED260.1 (VSS), LED261.1 (VSS), LED262.1 (VSS), LED263.1 (VSS), LED264.1 (VSS), LED265.1 (VSS), LED266.1 (VSS), LED267.1 (VSS), LED268.1 (VSS), LED269.1 (VSS), LED270.1 (VSS), LED271.1 (VSS), LED272.1 (VSS), LED273.1 (VSS), LED274.1 (VSS), LED275.1 (VSS), LED279.1 (VSS), LED281.1 (VSS); also elsewhere on the board
unnamed: LED201.2 (DIN), R201.2
unnamed: LED201.4 (DOUT), LED202.2 (DIN)
unnamed: LED202.4 (DOUT), LED203.2 (DIN)
unnamed: LED203.4 (DOUT), LED204.2 (DIN)
unnamed: LED204.4 (DOUT), LED205.2 (DIN)
unnamed: LED205.4 (DOUT), LED206.2 (DIN)
unnamed: LED206.4 (DOUT), LED207.2 (DIN)
unnamed: LED207.4 (DOUT), LED208.2 (DIN)
unnamed: LED208.4 (DOUT), LED209.2 (DIN)
unnamed: LED209.4 (DOUT), LED210.2 (DIN)
unnamed: LED210.4 (DOUT), LED211.2 (DIN)
unnamed: LED211.4 (DOUT), LED212.2 (DIN)
unnamed: LED212.4 (DOUT), LED213.2 (DIN)
unnamed: LED213.4 (DOUT), LED214.2 (DIN)
unnamed: LED214.4 (DOUT), LED215.2 (DIN)
unnamed: LED215.4 (DOUT), LED216.2 (DIN)
unnamed: LED216.4 (DOUT), LED217.2 (DIN)
unnamed: LED217.4 (DOUT), LED218.2 (DIN)
unnamed: LED218.4 (DOUT), LED219.2 (DIN)
unnamed: LED219.4 (DOUT), LED220.2 (DIN)
unnamed: LED220.4 (DOUT), LED221.2 (DIN)
unnamed: LED221.4 (DOUT), LED222.2 (DIN)
unnamed: LED222.4 (DOUT), LED223.2 (DIN)
unnamed: LED223.4 (DOUT), LED224.2 (DIN)
unnamed: LED224.4 (DOUT), LED225.2 (DIN)
unnamed: LED225.4 (DOUT), LED226.2 (DIN)
unnamed: LED226.4 (DOUT), LED227.2 (DIN)
unnamed: LED227.4 (DOUT), LED228.2 (DIN)
unnamed: LED228.4 (DOUT), LED229.2 (DIN)
unnamed: LED229.4 (DOUT), LED230.2 (DIN)
unnamed: LED230.4 (DOUT), LED231.2 (DIN)
unnamed: LED231.4 (DOUT), LED232.2 (DIN)
unnamed: LED232.4 (DOUT), LED233.2 (DIN)
unnamed: LED233.4 (DOUT), LED234.2 (DIN)
unnamed: LED234.4 (DOUT), LED235.2 (DIN)
unnamed: LED235.4 (DOUT), LED236.2 (DIN)
unnamed: LED236.4 (DOUT), LED237.2 (DIN)
unnamed: LED237.4 (DOUT), LED238.2 (DIN)
unnamed: LED238.4 (DOUT), LED239.2 (DIN)
unnamed: LED239.4 (DOUT), LED240.2 (DIN)
unnamed: LED240.4 (DOUT), LED241.2 (DIN)
unnamed: LED241.4 (DOUT), LED242.2 (DIN)
unnamed: LED242.4 (DOUT), LED243.2 (DIN)
unnamed: LED243.4 (DOUT), LED244.2 (DIN)
unnamed: LED244.4 (DOUT), LED245.2 (DIN)
unnamed: LED245.4 (DOUT), LED246.2 (DIN)
unnamed: LED246.4 (DOUT), LED247.2 (DIN)
unnamed: LED247.4 (DOUT), LED248.2 (DIN)
unnamed: LED248.4 (DOUT), LED249.2 (DIN)
unnamed: LED249.4 (DOUT), LED250.2 (DIN)
unnamed: LED250.4 (DOUT), LED251.2 (DIN)
unnamed: LED251.4 (DOUT), LED252.2 (DIN)
unnamed: LED252.4 (DOUT), LED253.2 (DIN)
unnamed: LED253.4 (DOUT), LED254.2 (DIN)
unnamed: LED254.4 (DOUT), LED255.2 (DIN)
unnamed: LED255.4 (DOUT), LED256.2 (DIN)
unnamed: LED256.4 (DOUT), LED257.2 (DIN)
unnamed: LED257.4 (DOUT), LED258.2 (DIN)
unnamed: LED258.4 (DOUT), LED259.2 (DIN)
unnamed: LED259.4 (DOUT), LED260.2 (DIN)
unnamed: LED260.4 (DOUT), LED261.2 (DIN)
unnamed: LED261.4 (DOUT), LED262.2 (DIN)
unnamed: LED262.4 (DOUT), LED263.2 (DIN)
unnamed: LED263.4 (DOUT), LED264.2 (DIN)
unnamed: LED264.4 (DOUT), LED265.2 (DIN)
unnamed: LED265.4 (DOUT), LED266.2 (DIN)
unnamed: LED266.4 (DOUT), LED267.2 (DIN)
unnamed: LED267.4 (DOUT), LED268.2 (DIN)
unnamed: LED268.4 (DOUT), LED269.2 (DIN)
unnamed: LED269.4 (DOUT), LED270.2 (DIN)
unnamed: LED270.4 (DOUT), LED279.2 (DIN)
unnamed: LED271.2 (DIN), LED279.4 (DOUT)
unnamed: LED271.4 (DOUT), LED281.2 (DIN)
unnamed: LED272.2 (DIN), LED281.4 (DOUT)
unnamed: LED272.4 (DOUT), LED273.2 (DIN)
unnamed: LED273.4 (DOUT), LED274.2 (DIN)
unnamed: LED274.4 (DOUT), LED275.2 (DIN)
unnamed: LED275.4 (DOUT), R202.2

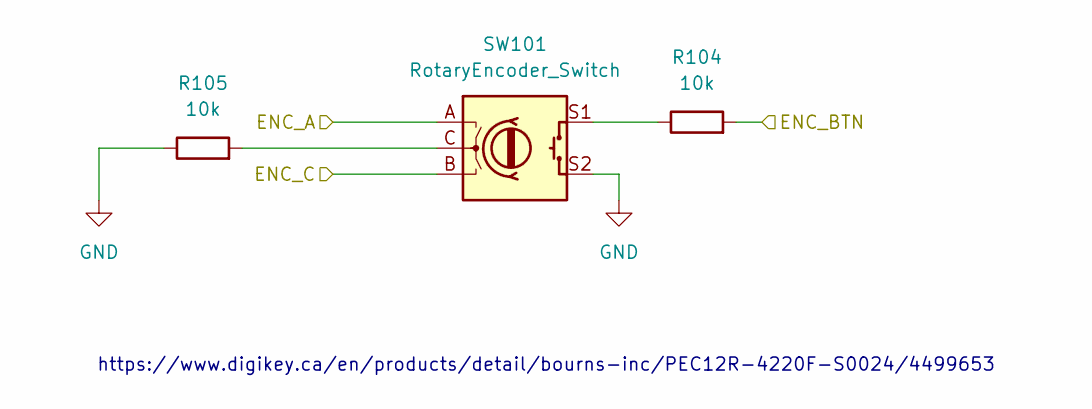
[picture p6: schematic encoder.kicad_sch]

Parts:
R104, R105: 10k; R_0603_1608Metric; JLC Part# C25804
SW101: RotaryEncoder_Switch; RotaryEncoder_Alps_EC11E-Switch_Vertical_H20mm_MountingHoles

Connections:
/Controller/GPIO27: SW101.A; also elsewhere on the board
/Controller/GPIO28: R104.2; also elsewhere on the board
/Controller/GPIO29: SW101.B; also elsewhere on the board
GND: R105.1, SW101.S2; also elsewhere on the board
unnamed: R104.1, SW101.S1
unnamed: R105.2, SW101.C

Notes on the sheet:
https://www.digikey.ca/en/products/detail/bourns-inc/PEC12R-4220F-S0024/4499653

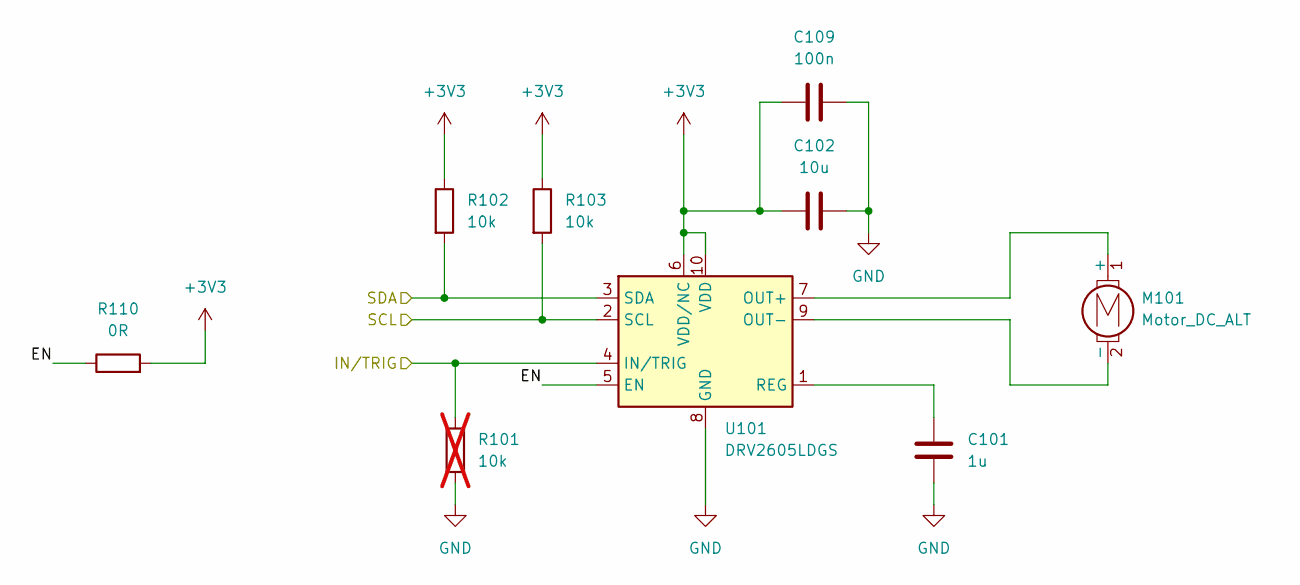
[picture p7: schematic haptic.kicad_sch]

Parts:
C101: 1u; C_0603_1608Metric; JLC Part# C15849
C102: 10u; C_0805_2012Metric; JLC Part# C15850
C109: 100n; C_0402_1005Metric; JLC Part# C307331
M101: Motor_DC_ALT; PinHeader_1x02_P2.54mm_Vertical
R101: 10k; R_0603_1608Metric; JLC Part# C25804; not fitted
R102, R103: 10k; R_0603_1608Metric; JLC Part# C25804
R110: 0R; R_0603_1608Metric; JLC Part# C21189
U101: DRV2605LDGS; TSSOP-10_3x3mm_P0.5mm

Connections:
+3V3: C102.1, C109.1, R102.1, R103.1, R110.2, U101.6 (VDD/NC), U101.10 (VDD); also elsewhere on the board
/Controller/GPIO32: R101.1, U101.4 (IN/TRIG); also elsewhere on the board
/Controller/GPIO34: R102.2, U101.3 (SDA); also elsewhere on the board
/Controller/GPIO35: R103.2, U101.2 (SCL); also elsewhere on the board
/Haptic/EN: R110.1, U101.5 (EN)
GND: C101.2, C102.2, C109.2, R101.2, U101.8 (GND); also elsewhere on the board
unnamed: M101.1 (+), U101.7 (OUT+)
unnamed: M101.2 (-), U101.9 (OUT-)
unnamed: C101.1, U101.1 (REG)
