abinash18/KBUltra/Hardware/PCB/Mk1/Rev1/KBUltraMk1/KBUltraMk1.kicad_pcb

## KiCad design Hardware/PCB/Mk1/Rev1/KBUltraMk1/KBUltraMk1.kicad_pcb (continued)

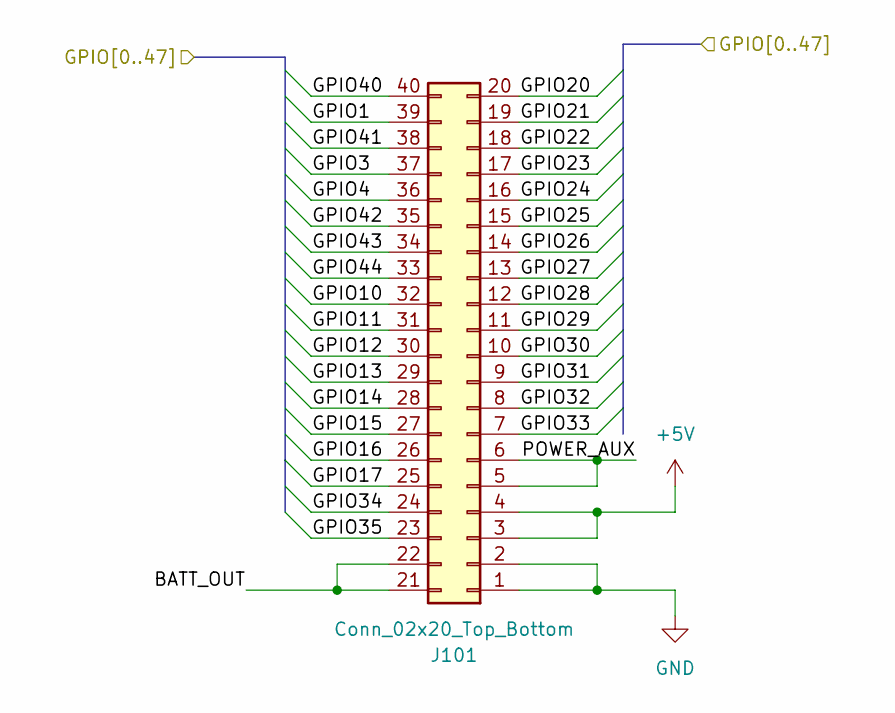
[picture p8: schematic controller.kicad_sch]

Parts:
J101: Conn_02x20_Top_Bottom; PinHeader_2x20_P2.54mm_Vertical

Connections:
+5V: J101.3, J101.4; also elsewhere on the board
/Controller/BATT_OUT: J101.21, J101.22
/Controller/GPIO1: J101.39; also elsewhere on the board
/Controller/GPIO3: J101.37; also elsewhere on the board
/Controller/GPIO4: J101.36; also elsewhere on the board
/Controller/GPIO10: J101.32; also elsewhere on the board
/Controller/GPIO11: J101.31; also elsewhere on the board
/Controller/GPIO12: J101.30; also elsewhere on the board
/Controller/GPIO13: J101.29; also elsewhere on the board
/Controller/GPIO14: J101.28; also elsewhere on the board
/Controller/GPIO15: J101.27; also elsewhere on the board
/Controller/GPIO16: J101.26; also elsewhere on the board
/Controller/GPIO17: J101.25; also elsewhere on the board
/Controller/GPIO20: J101.20; also elsewhere on the board
/Controller/GPIO21: J101.19; also elsewhere on the board
/Controller/GPIO22: J101.18; also elsewhere on the board
/Controller/GPIO23: J101.17; also elsewhere on the board
/Controller/GPIO24: J101.16; also elsewhere on the board
/Controller/GPIO25: J101.15; also elsewhere on the board
/Controller/GPIO26: J101.14; also elsewhere on the board
/Controller/GPIO27: J101.13; also elsewhere on the board
/Controller/GPIO28: J101.12; also elsewhere on the board
/Controller/GPIO29: J101.11; also elsewhere on the board
/Controller/GPIO30: J101.10; also elsewhere on the board
/Controller/GPIO31: J101.9; also elsewhere on the board
/Controller/GPIO32: J101.8; also elsewhere on the board
/Controller/GPIO33: J101.7; also elsewhere on the board
/Controller/GPIO34: J101.24; also elsewhere on the board
/Controller/GPIO35: J101.23; also elsewhere on the board
/Controller/GPIO40: J101.40; also elsewhere on the board
/Controller/GPIO41: J101.38; also elsewhere on the board
/Controller/GPIO42: J101.35; also elsewhere on the board
/Controller/GPIO43: J101.34; also elsewhere on the board
/Controller/GPIO44: J101.33; also elsewhere on the board
/Controller/POWER_AUX: J101.5, J101.6
GND: J101.1, J101.2; also elsewhere on the board

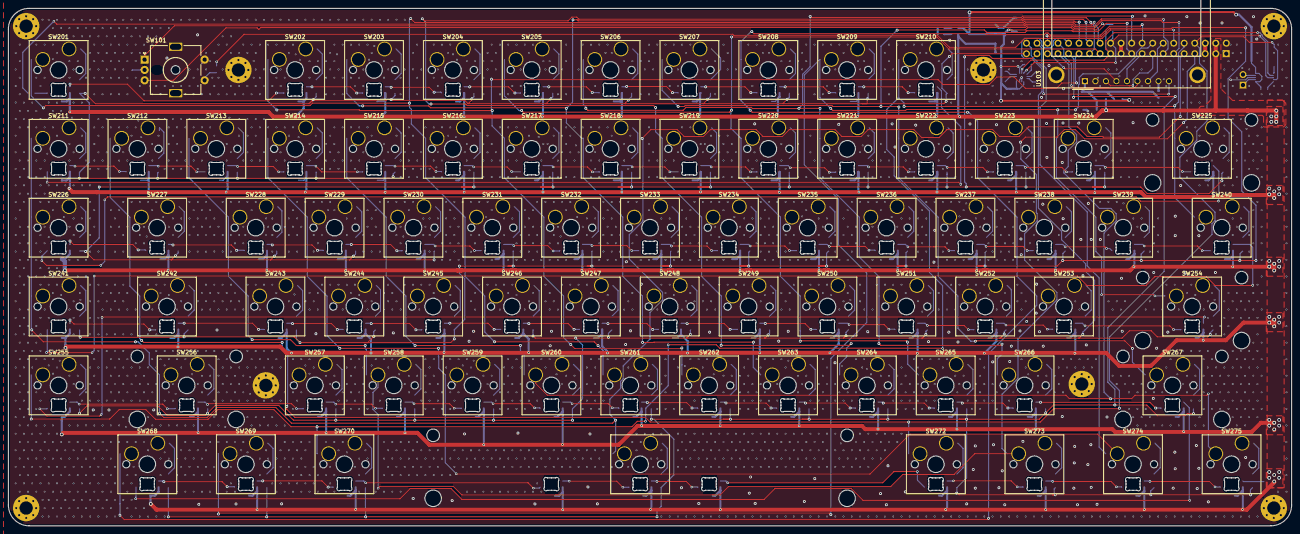
[picture p9: board KBUltraMk1.kicad_pcb from above]

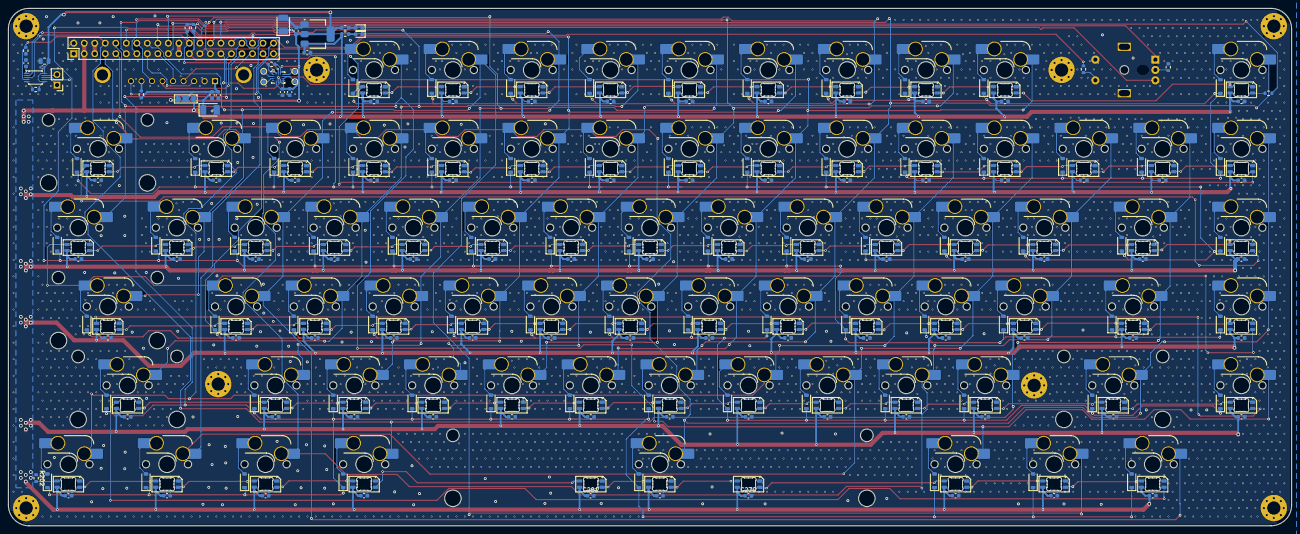
[picture p10: board KBUltraMk1.kicad_pcb from below]

Board: 2 copper layers, 310.0 x 125.0 mm, 354 parts (264 on the bottom side), 205 nets.
