abinash18/KBUltra/ControlCardRP/Hardware/Rev1/ControlCardRP/ControlCardRP.kicad_pcb

## KiCad design ControlCardRP/Hardware/Rev1/ControlCardRP/ControlCardRP.kicad_pcb (2026-09-08)

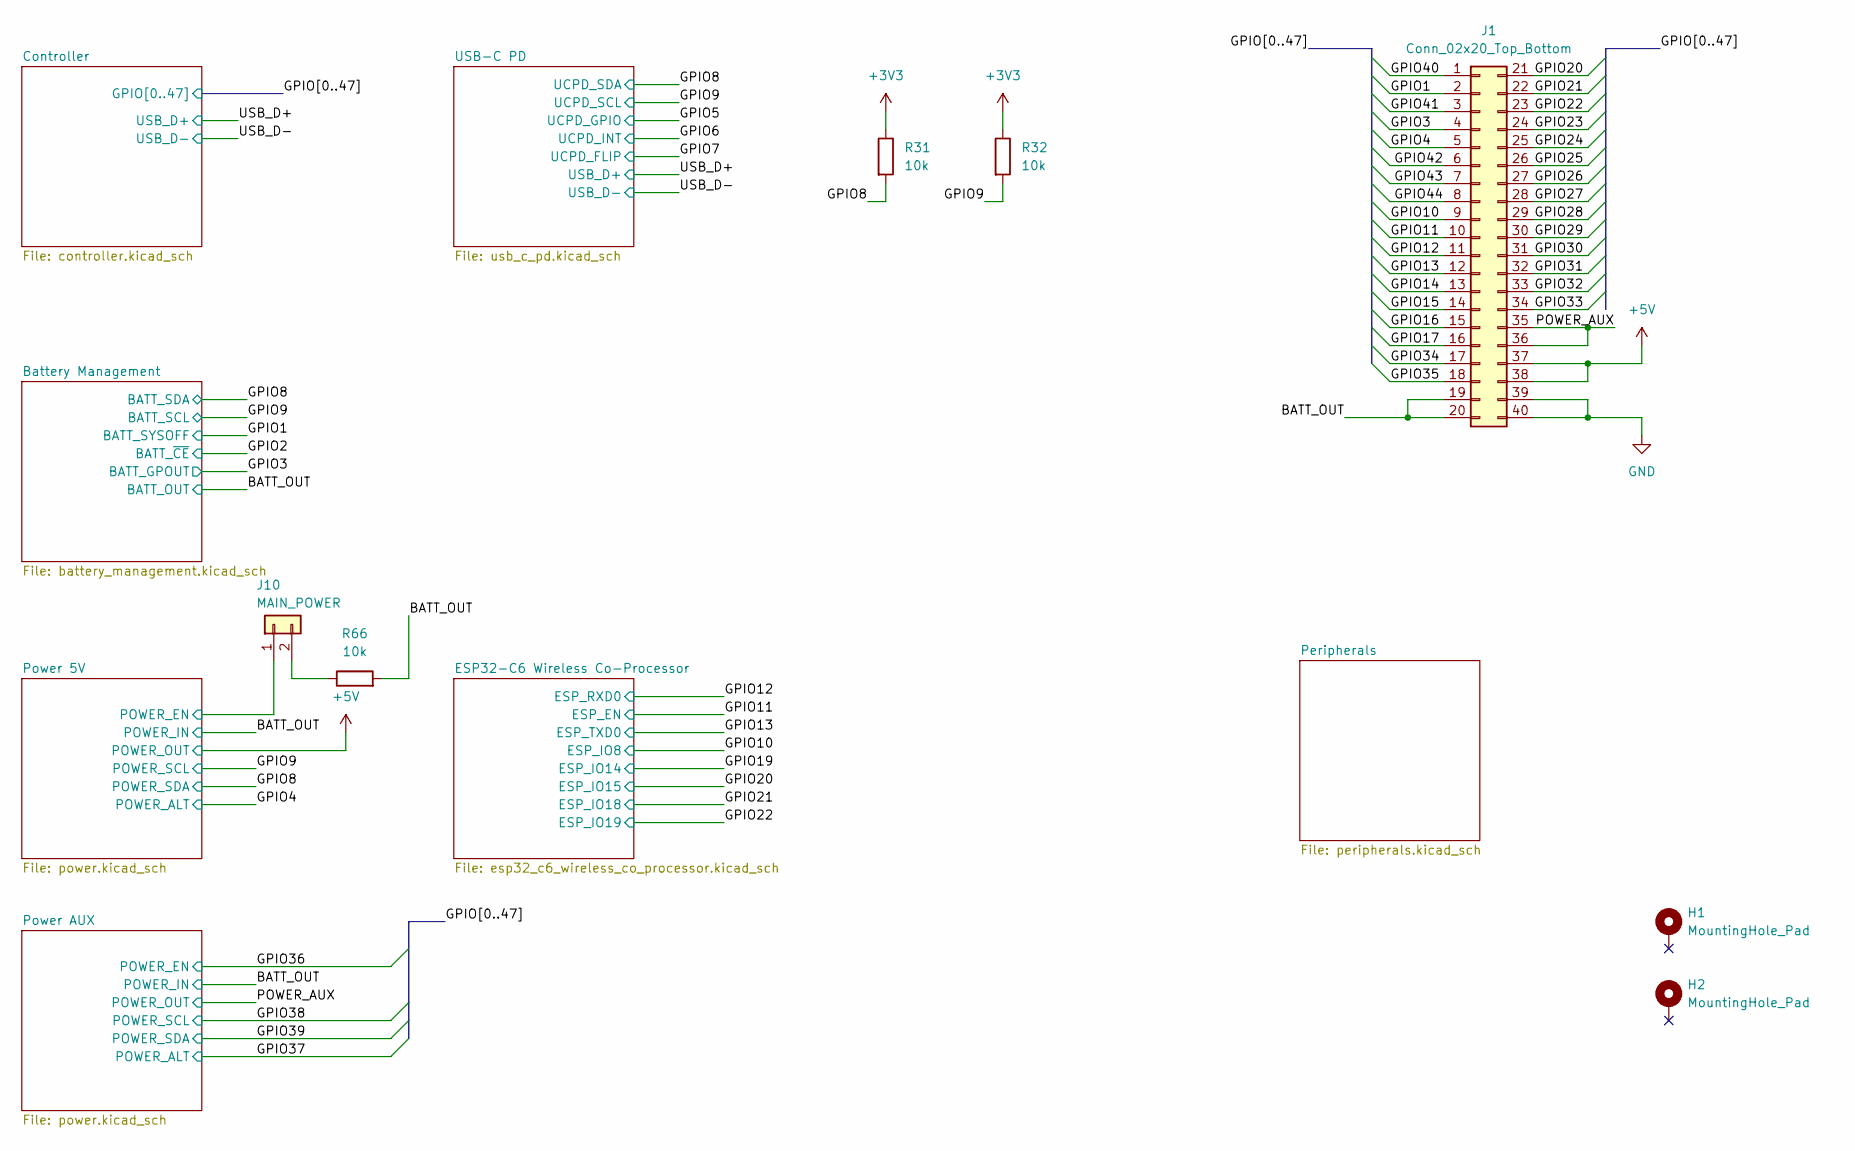
[picture p11: schematic ControlCardRP.kicad_sch]

Parts:
H1, H2: MountingHole_Pad; MountingHole_3.2mm_M3_Pad_Via
J1: Conn_02x20_Top_Bottom; PinSocket_2x20_P2.54mm_Vertical_SMD
J10: MAIN_POWER; PinHeader_1x02_P2.54mm_Vertical
R31, R32, R66: 10k; R_0402_1005Metric; LCSC Part # C25744

Connections:
+3V3: R31.1, R32.1; also elsewhere on the board
+5V: J1.37, J1.38; also elsewhere on the board
/BATT_OUT: J1.19, J1.20, R66.2; also elsewhere on the board
/GPIO1: J1.2; also elsewhere on the board
/GPIO3: J1.4; also elsewhere on the board
/GPIO4: J1.5; also elsewhere on the board
/GPIO8: R31.2; also elsewhere on the board
/GPIO9: R32.2; also elsewhere on the board
/GPIO10: J1.9; also elsewhere on the board
/GPIO11: J1.10; also elsewhere on the board
/GPIO12: J1.11; also elsewhere on the board
/GPIO13: J1.12; also elsewhere on the board
/GPIO14: J1.13; also elsewhere on the board
/GPIO15: J1.14; also elsewhere on the board
/GPIO16: J1.15; also elsewhere on the board
/GPIO17: J1.16; also elsewhere on the board
/GPIO20: J1.21; also elsewhere on the board
/GPIO21: J1.22; also elsewhere on the board
/GPIO22: J1.23; also elsewhere on the board
/GPIO23: J1.24; also elsewhere on the board
/GPIO24: J1.25; also elsewhere on the board
/GPIO25: J1.26; also elsewhere on the board
/GPIO26: J1.27; also elsewhere on the board
/GPIO27: J1.28; also elsewhere on the board
/GPIO28: J1.29; also elsewhere on the board
/GPIO29: J1.30; also elsewhere on the board
/GPIO30: J1.31; also elsewhere on the board
/GPIO31: J1.32; also elsewhere on the board
/GPIO32: J1.33; also elsewhere on the board
/GPIO33: J1.34; also elsewhere on the board
/GPIO34: J1.17; also elsewhere on the board
/GPIO35: J1.18; also elsewhere on the board
/GPIO40: J1.1; also elsewhere on the board
/GPIO41: J1.3; also elsewhere on the board
/GPIO42: J1.6; also elsewhere on the board
/GPIO43: J1.7; also elsewhere on the board
/GPIO44: J1.8; also elsewhere on the board
/POWER_AUX: J1.35, J1.36; also elsewhere on the board
/Power 5V/POWER_EN: J10.1; also elsewhere on the board
GND: J1.39, J1.40; also elsewhere on the board
unnamed: J10.2, R66.1

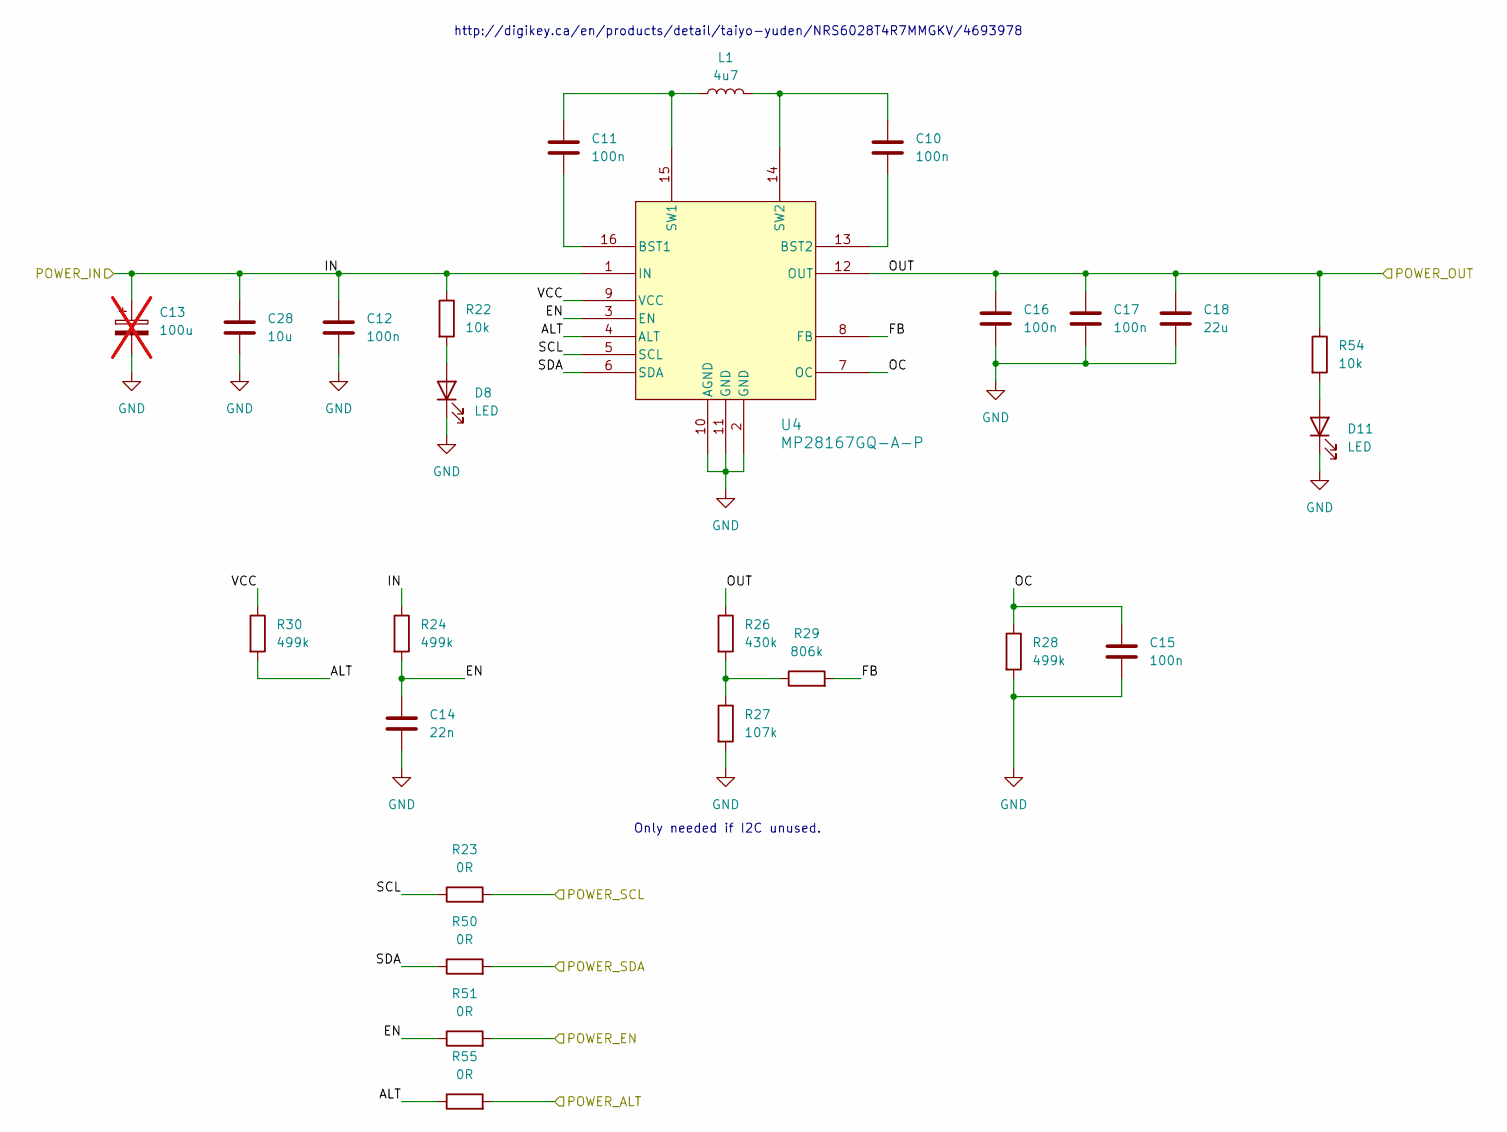
[picture p12: schematic power.kicad_sch]

Parts:
C10, C11, C12, C16, C17: 100n; C_0402_1005Metric; LCSC Part # C307331
C13: 100u; CP_Elec_5x5.4; not fitted
C14: 22n; C_0402_1005Metric; LCSC Part # C1532
C15: 100n; C_0402_1005Metric; LCSC Part # C1525
C18: 22u; C_1206_3216Metric; LCSC Part # C12891
C28: 10u; C_0603_1608Metric; LCSC Part # C96446
D8, D11: LED; LED_0603_1608Metric
L1: 4u7; L_Taiyo-Yuden_NR-60xx
R22, R54: 10k; R_0402_1005Metric; LCSC Part # C25744
R23, R50, R51, R55: 0R; R_0402_1005Metric; LCSC Part # C17168
R24, R28, R30: 499k; R_0402_1005Metric; LCSC Part # C25778
R26: 430k; R_0603_1608Metric; LCSC Part # C25969
R27: 107k; R_0603_1608Metric; LCSC Part # C25805
R29: 806k; R_0603_1608Metric; LCSC Part # C23240
U4: MP28167GQ-A-P; QFN-16_MP28167_MNP

Connections:
+5V: C16.1, C17.1, C18.1, R26.1, R54.1, U4.12 (OUT); also elsewhere on the board
/BATT_OUT: C12.1, C13.1, C28.1, R22.1, R24.1, U4.1 (IN); also elsewhere on the board
/GPIO4: R55.2; also elsewhere on the board
/GPIO8: R50.2; also elsewhere on the board
/GPIO9: R23.2; also elsewhere on the board
/Power 5V/ALT: R30.2, R55.1, U4.4 (ALT)
/Power 5V/EN: C14.1, R24.2, R51.1, U4.3 (EN)
/Power 5V/FB: R29.2, U4.8 (FB)
/Power 5V/OC: C15.1, R28.1, U4.7 (OC)
/Power 5V/POWER_EN: R51.2; also elsewhere on the board
/Power 5V/SCL: R23.1, U4.5 (SCL)
/Power 5V/SDA: R50.1, U4.6 (SDA)
/Power 5V/VCC: R30.1, U4.9 (VCC)
GND: C12.2, C13.2, C14.2, C15.2, C16.2, C17.2, C18.2, C28.2, D8.1 (K), D11.1 (K), R27.2, R28.2, U4.2 (GND), U4.10 (AGND), U4.11 (GND); also elsewhere on the board
unnamed: D8.2 (A), R22.2
unnamed: D11.2 (A), R54.2
unnamed: R26.2, R27.1, R29.1
unnamed: C11.2, U4.16 (BST1)
unnamed: C10.2, U4.13 (BST2)
unnamed: C11.1, L1.1, U4.15 (SW1)
unnamed: C10.1, L1.2, U4.14 (SW2)

Parts of its further copies:
C26: 100u; CP_Elec_5x5.4; not fitted
C27, C31, C32, C33, C34: 100n; C_0402_1005Metric; LCSC Part # C307331
C29: 10u; C_0603_1608Metric; LCSC Part # C96446
C30: 22n; C_0402_1005Metric; LCSC Part # C1532
C35: 100n; C_0402_1005Metric; LCSC Part # C1525
C36: 22u; C_1206_3216Metric; LCSC Part # C12891
D9, D12: LED; LED_0603_1608Metric
L2: 4u7; L_Taiyo-Yuden_NR-60xx
R52, R53, R64: 499k; R_0402_1005Metric; LCSC Part # C25778
R56, R65: 10k; R_0402_1005Metric; LCSC Part # C25744
R57, R58, R59, R60: 0R; R_0402_1005Metric; LCSC Part # C17168
R61: 430k; R_0603_1608Metric; LCSC Part # C25969
R62: 107k; R_0603_1608Metric; LCSC Part # C25805
R63: 806k; R_0603_1608Metric; LCSC Part # C23240
U8: MP28167GQ-A-P; QFN-16_MP28167_MNP

Connections of its further copies:
/BATT_OUT: C26.1, C27.1, C29.1, R53.1, R56.1, U8.1 (IN); also elsewhere on the board
/GPIO36: R59.2; also elsewhere on the board
/GPIO37: R60.2; also elsewhere on the board
/GPIO38: R57.2; also elsewhere on the board
/GPIO39: R58.2; also elsewhere on the board
/POWER_AUX: C33.1, C34.1, C36.1, R61.1, R65.1, U8.12 (OUT); also elsewhere on the board
/Power AUX/ALT: R52.2, R60.1, U8.4 (ALT)
/Power AUX/EN: C30.1, R53.2, R59.1, U8.3 (EN)
/Power AUX/FB: R63.2, U8.8 (FB)
/Power AUX/OC: C35.1, R64.1, U8.7 (OC)
/Power AUX/SCL: R57.1, U8.5 (SCL)
/Power AUX/SDA: R58.1, U8.6 (SDA)
/Power AUX/VCC: R52.1, U8.9 (VCC)
GND: C26.2, C27.2, C29.2, C30.2, C33.2, C34.2, C35.2, C36.2, D9.1 (K), D12.1 (K), R62.2, R64.2, U8.2 (GND), U8.10 (AGND), U8.11 (GND); also elsewhere on the board
unnamed: D9.2 (A), R56.2
unnamed: D12.2 (A), R65.2
unnamed: R61.2, R62.1, R63.1
unnamed: C31.2, U8.16 (BST1)
unnamed: C32.2, U8.13 (BST2)
unnamed: C31.1, L2.1, U8.15 (SW1)
unnamed: C32.1, L2.2, U8.14 (SW2)

Notes on the sheet:
http://digikey.ca/en/products/detail/taiyo-yuden/NRS6028T4R7MMGKV/4693978
Only needed if I2C unused.

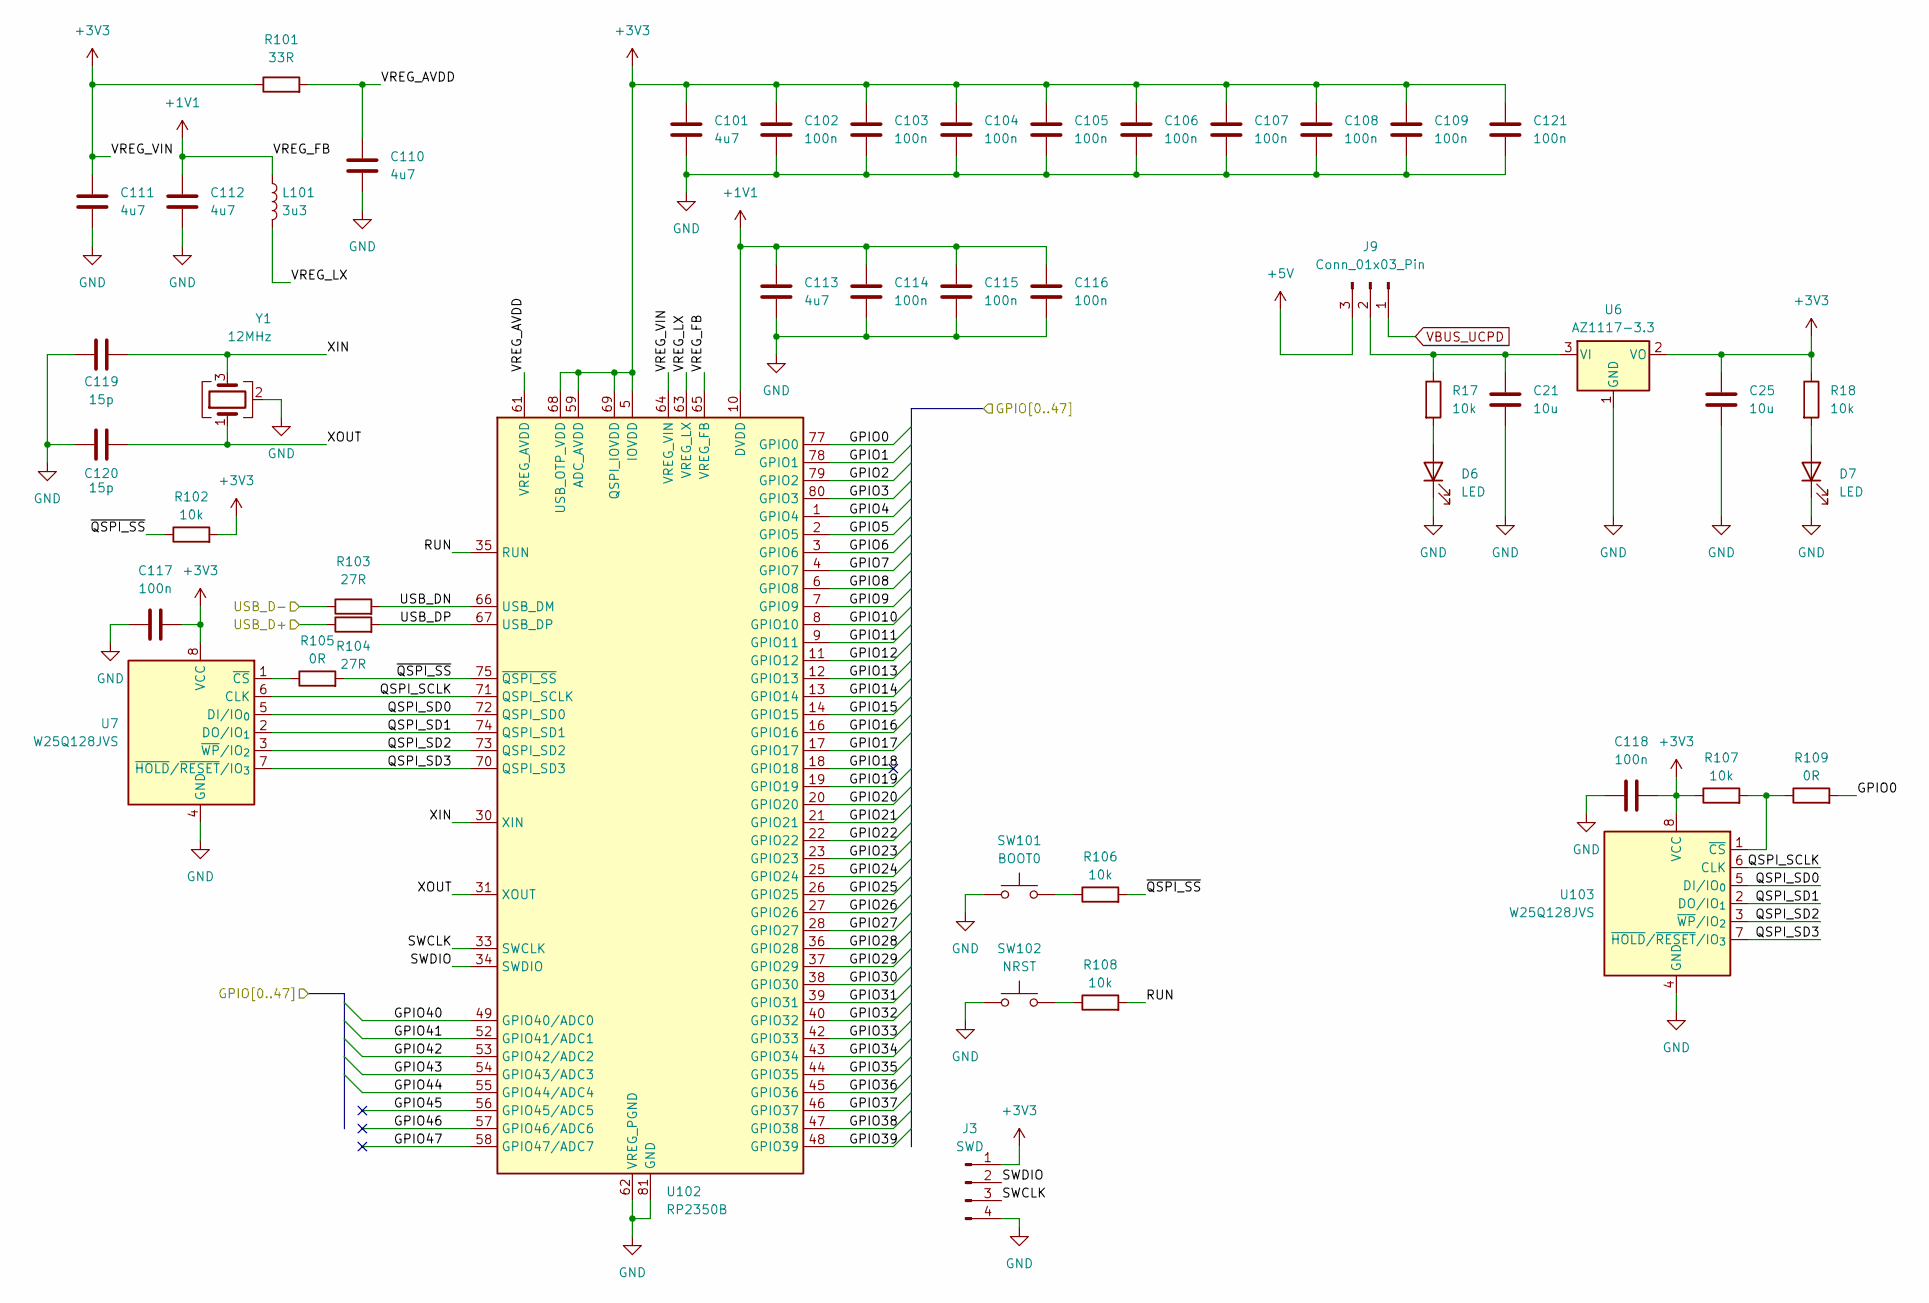
[picture p13: schematic controller.kicad_sch]

Parts:
C21, C25: 10u; C_0603_1608Metric; LCSC Part # C96446
C101, C110, C111, C112, C113: 4u7; C_0402_1005Metric; LCSC Part # C23733
C102, C103, C104, C105, C106, C107, C108, C109, C114, C115, C116, C117, C118, C121: 100n; C_0402_1005Metric; LCSC Part # C1525
C119, C120: 15p; C_0402_1005Metric; LCSC Part # C1548
D6, D7: LED; LED_0603_1608Metric
J3: SWD; PinHeader_1x04_P2.54mm_Vertical
J9: Conn_01x03_Pin; PinHeader_1x03_P1.27mm_Vertical
L101: 3u3; AOTA-B201610S3R3-101-T
R17, R18, R102, R106, R107, R108: 10k; R_0402_1005Metric; LCSC Part # C25744
R101: 33R; R_0402_1005Metric; LCSC Part # C25105
R103, R104: 27R; R_0603_1608Metric; LCSC Part # C25190
R105, R109: 0R; R_0402_1005Metric; LCSC Part # C17168
SW101: BOOT0; SW_SPST_PTS810
SW102: NRST; SW_SPST_PTS810
U6: AZ1117-3.3; SOT-89-3
U7, U103: W25Q128JVS; SOIC-8_5.3x5.3mm_P1.27mm
U102: RP2350B; QFN-80-1EP_10x10mm_P0.4mm_EP3.4x3.4mm
Y1: 12MHz; Crystal_SMD_3225-4Pin_3.2x2.5mm

Connections:
+1V1: C112.1, C113.1, C114.1, C115.1, C116.1, L101.1, U102.10 (DVDD), U102.32 (DVDD), U102.51 (DVDD), U102.65 (VREG_FB)
+3V3: C25.1, C101.1, C102.1, C103.1, C104.1, C105.1, C106.1, C107.1, C108.1, C109.1, C111.1, C117.2, C118.2, C121.1, J3.1, R18.1, R101.1, R102.2, R107.1, U6.2 (VO), U7.8 (VCC), U102.5 (IOVDD), U102.15 (IOVDD), U102.24 (IOVDD), U102.29 (IOVDD), U102.41 (IOVDD), U102.50 (IOVDD), U102.59 (ADC_AVDD), U102.60 (IOVDD), U102.64 (VREG_VIN), U102.68 (USB_OTP_VDD), U102.69 (QSPI_IOVDD), U102.76 (IOVDD), U103.8 (VCC); also elsewhere on the board
+5V: J9.3; also elsewhere on the board
/Controller/QSPI_SCLK: U7.6 (CLK), U102.71 (QSPI_SCLK), U103.6 (CLK)
/Controller/QSPI_SD0: U7.5 (DI/IO_{0}), U102.72 (QSPI_SD0), U103.5 (DI/IO_{0})
/Controller/QSPI_SD1: U7.2 (DO/IO_{1}), U102.74 (QSPI_SD1), U103.2 (DO/IO_{1})
/Controller/QSPI_SD2: U7.3 (~WP/IO_{2}), U102.73 (QSPI_SD2), U103.3 (~WP/IO_{2})
/Controller/QSPI_SD3: U7.7 (~HOLD/~RESET/IO_{3}), U102.70 (QSPI_SD3), U103.7 (~HOLD/~RESET/IO_{3})
/Controller/RUN: R108.2, U102.35 (RUN)
/Controller/SWCLK: J3.3, U102.33 (SWCLK)
/Controller/SWDIO: J3.2, U102.34 (SWDIO)
/Controller/USB_DN: R103.2, U102.66 (USB_DM)
/Controller/USB_DP: R104.2, U102.67 (USB_DP)
/Controller/VREG_AVDD: C110.1, R101.2, U102.61 (VREG_AVDD)
/Controller/VREG_LX: L101.2, U102.63 (VREG_LX)
/Controller/XIN: C119.2, U102.30 (XIN), Y1.3
/Controller/XOUT: C120.1, U102.31 (XOUT), Y1.1
/Controller/~QSPI_SS: R102.1, R105.2, R106.2, U102.75 (~QSPI_SS)
/GPIO0: R109.2, U102.77 (GPIO0)
/GPIO1: U102.78 (GPIO1); also elsewhere on the board
/GPIO2: U102.79 (GPIO2); also elsewhere on the board
/GPIO3: U102.80 (GPIO3); also elsewhere on the board
/GPIO4: U102.1 (GPIO4); also elsewhere on the board
/GPIO5: U102.2 (GPIO5); also elsewhere on the board
/GPIO6: U102.3 (GPIO6); also elsewhere on the board
/GPIO7: U102.4 (GPIO7); also elsewhere on the board
/GPIO8: U102.6 (GPIO8); also elsewhere on the board
/GPIO9: U102.7 (GPIO9); also elsewhere on the board
/GPIO10: U102.8 (GPIO10); also elsewhere on the board
/GPIO11: U102.9 (GPIO11); also elsewhere on the board
/GPIO12: U102.11 (GPIO12); also elsewhere on the board
/GPIO13: U102.12 (GPIO13); also elsewhere on the board
/GPIO14: U102.13 (GPIO14); also elsewhere on the board
/GPIO15: U102.14 (GPIO15); also elsewhere on the board
/GPIO16: U102.16 (GPIO16); also elsewhere on the board
/GPIO17: U102.17 (GPIO17); also elsewhere on the board
/GPIO18: U102.18 (GPIO18)
/GPIO19: U102.19 (GPIO19); also elsewhere on the board
/GPIO20: U102.20 (GPIO20); also elsewhere on the board
/GPIO21: U102.21 (GPIO21); also elsewhere on the board
/GPIO22: U102.22 (GPIO22); also elsewhere on the board
/GPIO23: U102.23 (GPIO23); also elsewhere on the board
/GPIO24: U102.25 (GPIO24); also elsewhere on the board
/GPIO25: U102.26 (GPIO25); also elsewhere on the board
/GPIO26: U102.27 (GPIO26); also elsewhere on the board
/GPIO27: U102.28 (GPIO27); also elsewhere on the board
/GPIO28: U102.36 (GPIO28); also elsewhere on the board
/GPIO29: U102.37 (GPIO29); also elsewhere on the board
/GPIO30: U102.38 (GPIO30); also elsewhere on the board
/GPIO31: U102.39 (GPIO31); also elsewhere on the board
/GPIO32: U102.40 (GPIO32); also elsewhere on the board
/GPIO33: U102.42 (GPIO33); also elsewhere on the board
/GPIO34: U102.43 (GPIO34); also elsewhere on the board
/GPIO35: U102.44 (GPIO35); also elsewhere on the board
/GPIO36: U102.45 (GPIO36); also elsewhere on the board
/GPIO37: U102.46 (GPIO37); also elsewhere on the board
/GPIO38: U102.47 (GPIO38); also elsewhere on the board
/GPIO39: U102.48 (GPIO39); also elsewhere on the board
/GPIO40: U102.49 (GPIO40/ADC0); also elsewhere on the board
/GPIO41: U102.52 (GPIO41/ADC1); also elsewhere on the board
/GPIO42: U102.53 (GPIO42/ADC2); also elsewhere on the board
/GPIO43: U102.54 (GPIO43/ADC3); also elsewhere on the board
/GPIO44: U102.55 (GPIO44/ADC4); also elsewhere on the board
/GPIO45: U102.56 (GPIO45/ADC5)
/GPIO46: U102.57 (GPIO46/ADC6)
/GPIO47: U102.58 (GPIO47/ADC7)
/USB_D+: R104.1; also elsewhere on the board
/USB_D-: R103.1; also elsewhere on the board
GND: C21.2, C25.2, C101.2, C102.2, C103.2, C104.2, C105.2, C106.2, C107.2, C108.2, C109.2, C110.2, C111.2, C112.2, C113.2, C114.2, C115.2, C116.2, C117.1, C118.1, C119.1, C120.2, C121.2, D6.1 (K), D7.1 (K), J3.4, SW101.1, SW102.1, U6.1 (GND), U7.4 (GND), U102.62 (VREG_PGND), U102.81 (GND), U103.4 (GND), Y1.2 (G), Y1.4 (G); also elsewhere on the board
unnamed: D6.2 (A), R17.2
unnamed: D7.2 (A), R18.2
unnamed: C21.1, J9.2, R17.1, U6.3 (VI)
unnamed: R106.1, SW101.2
unnamed: R108.1, SW102.2
unnamed: R105.1, U7.1 (~CS)
unnamed: R107.2, R109.1, U103.1 (~CS)
VBUS_UCPD: J9.1; also elsewhere on the board

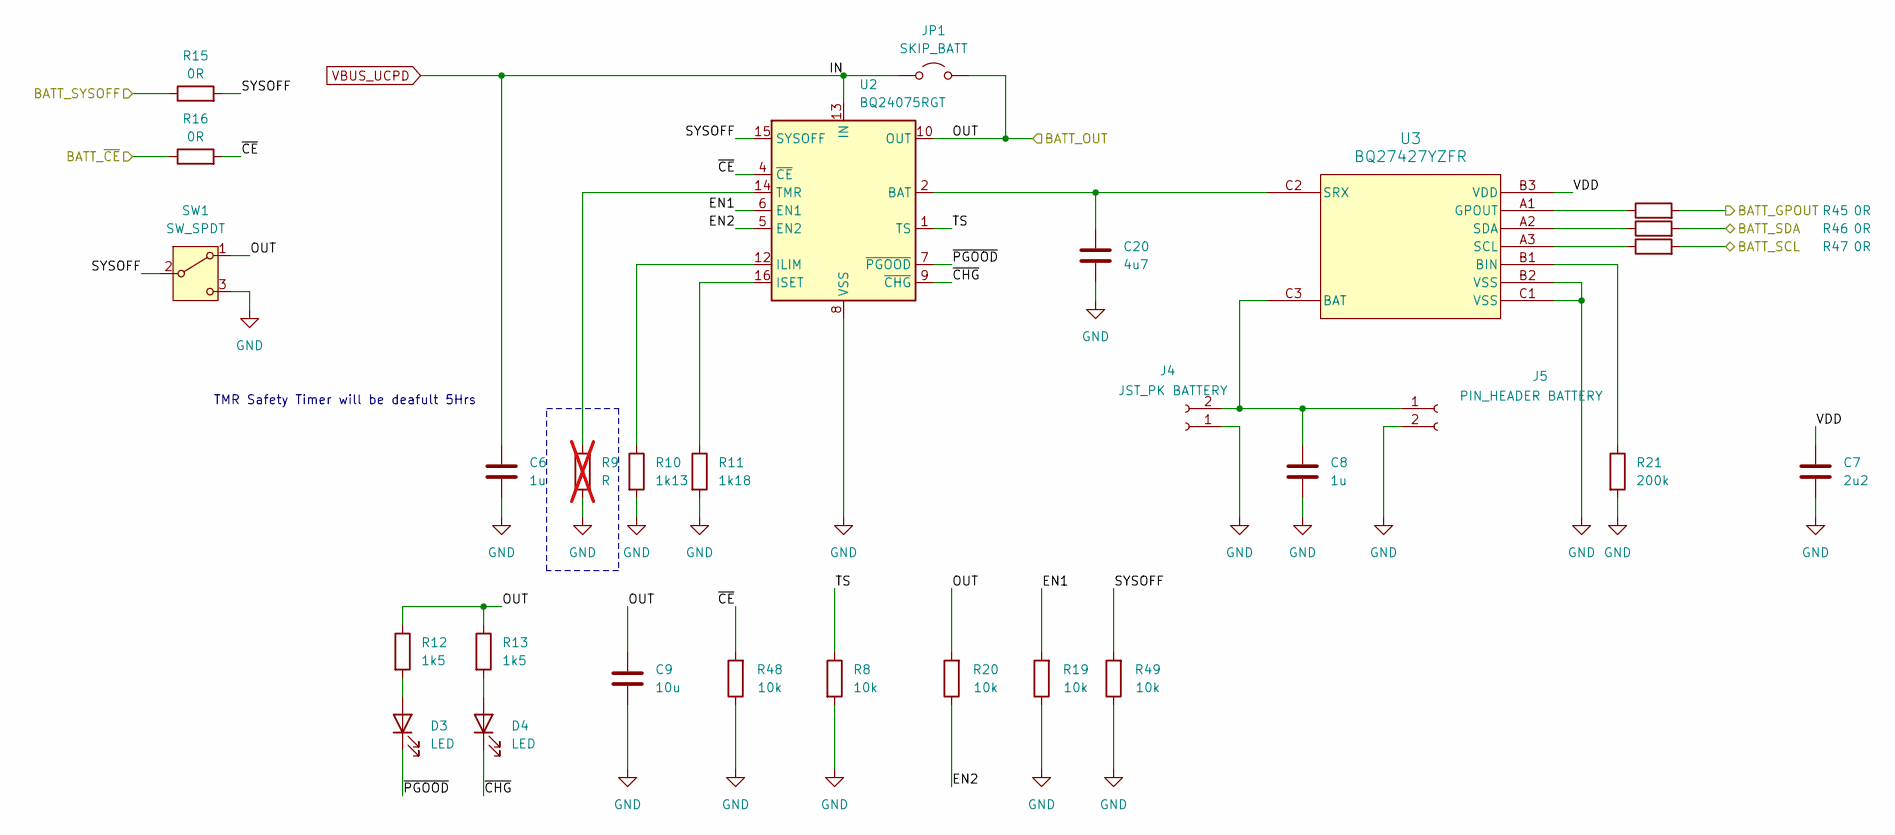
[picture p14: schematic battery_management.kicad_sch]

Parts:
C6, C8: 1u; C_0603_1608Metric; LCSC Part # C15849
C7: 2u2; C_0603_1608Metric; LCSC Part # C12530
C9: 10u; C_0603_1608Metric; LCSC Part # C96446
C20: 4u7; C_0402_1005Metric; LCSC Part # C23733
D3, D4: LED; LED_0603_1608Metric
J4: JST_PK BATTERY; JST_PH_S2B-PH-K_1x02_P2.00mm_Horizontal
J5: PIN_HEADER BATTERY; PinSocket_1x02_P2.54mm_Vertical
JP1: SKIP_BATT; SolderJumper-2_P1.3mm_Open_TrianglePad1.0x1.5mm
R8, R19, R20, R48, R49: 10k; R_0402_1005Metric; LCSC Part # C25744
R9: R; R_0402_1005Metric; not fitted
R10: 1k13; R_0402_1005Metric; LCSC Part # C25862
R11: 1k18; R_0402_1005Metric; LCSC Part # C25867
R12, R13: 1k5; R_0402_1005Metric; LCSC Part # C25867
R15, R16, R45, R46, R47: 0R; R_0402_1005Metric; LCSC Part # C17168
R21: 200k; R_0402_1005Metric; LCSC Part # C25764
SW1: SW_SPDT; SW_SPDT_PCM12
U2: BQ24075RGT; VQFN-16-1EP_3x3mm_P0.5mm_EP1.6x1.6mm
U3: BQ27427YZFR; DSBGA9-YZF_TEX

Connections:
/BATT_OUT: C9.1, JP1.2 (B), R12.1, R13.1, R20.2, SW1.1 (A), U2.10 (OUT), U2.11 (OUT); also elsewhere on the board
/Battery Management/EN1: R19.2, U2.6 (EN1)
/Battery Management/EN2: R20.1, U2.5 (EN2)
/Battery Management/SYSOFF: R15.2, R49.2, SW1.2 (B), U2.15 (SYSOFF)
/Battery Management/TS: R8.1, U2.1 (TS)
/Battery Management/VDD: C7.1, U3.B3 (VDD)
/Battery Management/~CE: R16.2, R48.2, U2.4 (~CE)
/Battery Management/~CHG: D4.1 (K), U2.9 (~CHG)
/Battery Management/~PGOOD: D3.1 (K), U2.7 (~PGOOD)
/GPIO1: R15.1; also elsewhere on the board
/GPIO2: R16.1; also elsewhere on the board
/GPIO3: R45.2; also elsewhere on the board
/GPIO8: R46.2; also elsewhere on the board
/GPIO9: R47.2; also elsewhere on the board
GND: C6.2, C7.2, C8.2, C9.2, C20.2, J4.1, J5.2, R8.2, R9.2, R10.2, R11.2, R19.1, R21.2, R48.1, R49.1, SW1.3 (C), U2.8 (VSS), U2.17 (VSS), U3.B2 (VSS), U3.C1 (VSS); also elsewhere on the board
unnamed: D3.2 (A), R12.2
unnamed: D4.2 (A), R13.2
unnamed: C8.1, J4.2, J5.1, U3.C3 (BAT)
unnamed: R10.1, U2.12 (ILIM)
unnamed: R11.1, U2.16 (ISET)
unnamed: R9.1, U2.14 (TMR)
unnamed: R21.1, U3.B1 (BIN)
unnamed: R45.1, U3.A1 (GPOUT)
unnamed: R47.1, U3.A3 (SCL)
unnamed: R46.1, U3.A2 (SDA)
unnamed: C20.1, U2.2 (BAT), U2.3 (BAT), U3.C2 (SRX)
VBUS_UCPD: C6.1, JP1.1 (A), U2.13 (IN); also elsewhere on the board

Notes on the sheet:
TMR Safety Timer will be deafult 5Hrs

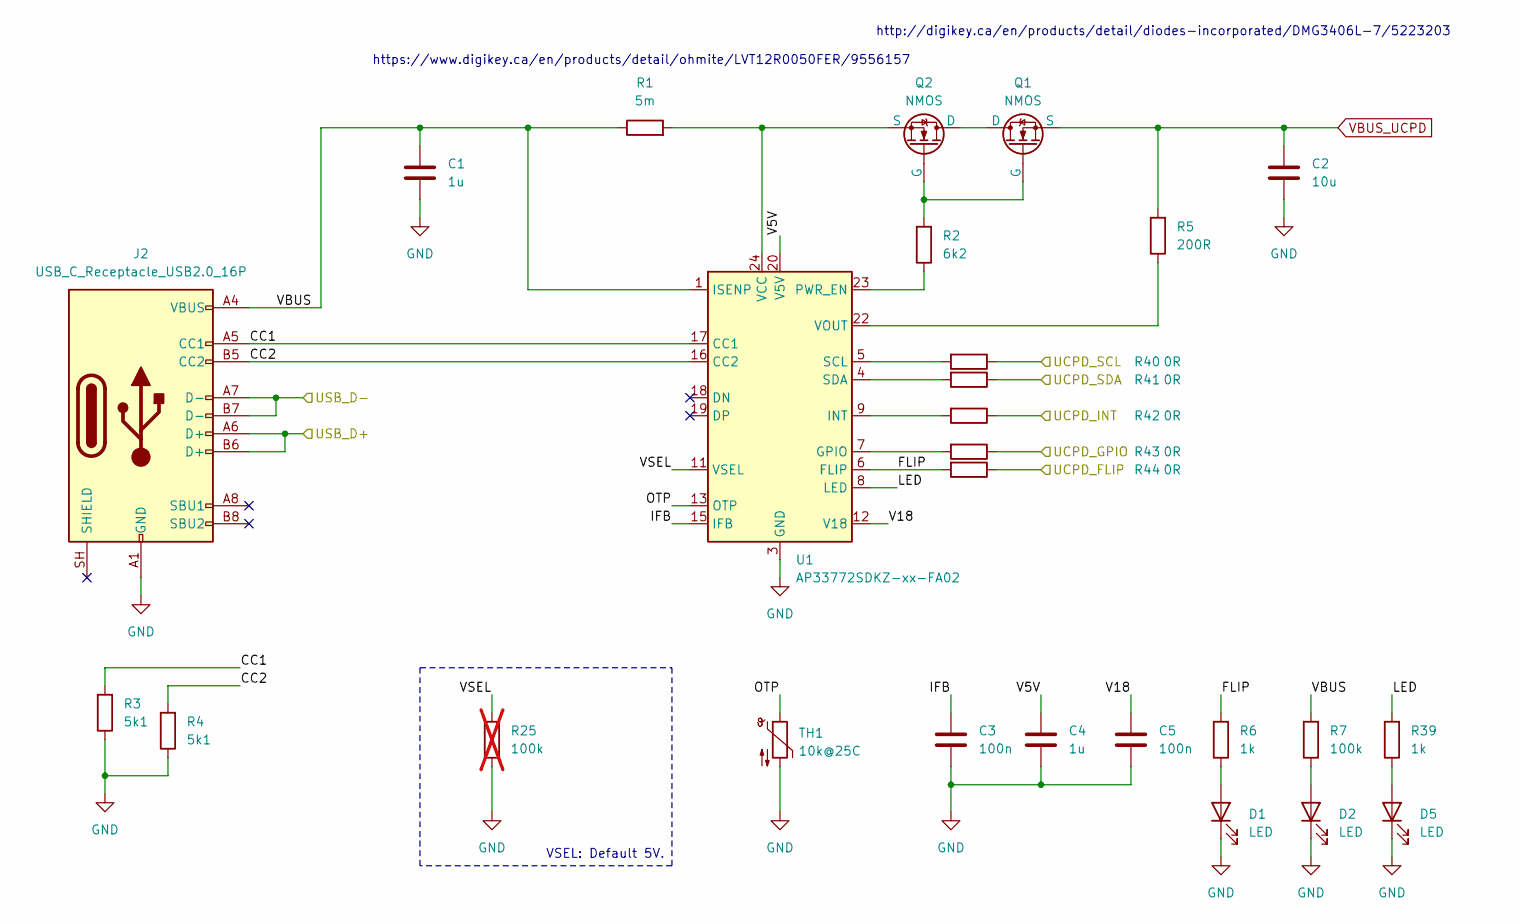
[picture p15: schematic usb_c_pd.kicad_sch]

Parts:
C1, C4: 1u; C_0603_1608Metric; LCSC Part # C15849
C2: 10u; C_0603_1608Metric; LCSC Part # C96446
C3, C5: 100n; C_0402_1005Metric; LCSC Part # C307331
D1, D2, D5: LED; LED_0603_1608Metric
J2: USB_C_Receptacle_USB2.0_16P; USB_C_Receptacle_GCT_USB4105-xx-A_16P_TopMnt_Horizontal
Q1, Q2: NMOS; SOT-23-3
R1: 5m; R_1206_3216Metric
R2: 6k2; R_0402_1005Metric; LCSC Part # C25905
R3, R4: 5k1; R_0402_1005Metric; LCSC Part # C25905
R5: 200R; R_0402_1005Metric; LCSC Part # C25087
R6, R39: 1k; R_0402_1005Metric; LCSC Part # C11702
R7: 100k; R_0402_1005Metric; LCSC Part # C25741
R25: 100k; R_0402_1005Metric; LCSC Part # C25741; not fitted
R40, R41, R42, R43, R44: 0R; R_0402_1005Metric; LCSC Part # C17168
TH1: 10k@25C; R_0603_1608Metric
U1: AP33772SDKZ-xx-FA02; Texas_RTW_WQFN-24-1EP_4x4mm_P0.5mm_EP2.7x2.7mm

Connections:
/GPIO5: R43.1; also elsewhere on the board
/GPIO6: R42.1; also elsewhere on the board
/GPIO7: R44.1; also elsewhere on the board
/GPIO8: R41.1; also elsewhere on the board
/GPIO9: R40.1; also elsewhere on the board
/USB-C PD/CC1: J2.A5 (CC1), R3.2, U1.17 (CC1)
/USB-C PD/CC2: J2.B5 (CC2), R4.2, U1.16 (CC2)
/USB-C PD/FLIP: R6.2, R44.2, U1.6 (FLIP)
/USB-C PD/IFB: C3.1, U1.15 (IFB)
/USB-C PD/LED: R39.2, U1.8 (LED)
/USB-C PD/OTP: TH1.1, U1.13 (OTP)
/USB-C PD/V5V: C4.1, U1.20 (V5V)
/USB-C PD/V18: C5.1, U1.12 (V18)
/USB-C PD/VBUS: C1.1, J2.A4 (VBUS), J2.A9 (VBUS), J2.B4 (VBUS), J2.B9 (VBUS), R1.1, R7.2, U1.1 (ISENP)
/USB-C PD/VSEL: R25.2, U1.11 (VSEL)
/USB_D+: J2.A6 (D+), J2.B6 (D+); also elsewhere on the board
/USB_D-: J2.A7 (D-), J2.B7 (D-); also elsewhere on the board
GND: C1.2, C2.2, C3.2, C4.2, C5.2, D1.1 (K), D2.1 (K), D5.1 (K), J2.A1 (GND), J2.A12 (GND), J2.B1 (GND), J2.B12 (GND), R3.1, R4.1, R25.1, TH1.2, U1.3 (GND), U1.25 (GND); also elsewhere on the board
unnamed: D1.2 (A), R6.1
unnamed: D2.2 (A), R7.1
unnamed: D5.2 (A), R39.1
unnamed: Q1.1 (D), Q2.1 (D)
unnamed: Q1.2 (G), Q2.2 (G), R2.2
unnamed: Q2.3 (S), R1.2, U1.24 (VCC)
unnamed: R43.2, U1.7 (GPIO)
unnamed: R42.2, U1.9 (INT)
unnamed: R2.1, U1.23 (PWR_EN)
unnamed: R40.2, U1.5 (SCL)
unnamed: R41.2, U1.4 (SDA)
unnamed: R5.1, U1.22 (VOUT)
VBUS_UCPD: C2.1, Q1.3 (S), R5.2; also elsewhere on the board

Notes on the sheet:
http://digikey.ca/en/products/detail/diodes-incorporated/DMG3406L-7/5223203
VSEL: Default 5V.
https://www.digikey.ca/en/products/detail/ohmite/LVT12R0050FER/9556157
