abinash18/KBUltra/ControlCardRP/Hardware/Rev1/ControlCardRP/ControlCardRP.kicad_pcb

## KiCad design ControlCardRP/Hardware/Rev1/ControlCardRP/ControlCardRP.kicad_pcb (continued)

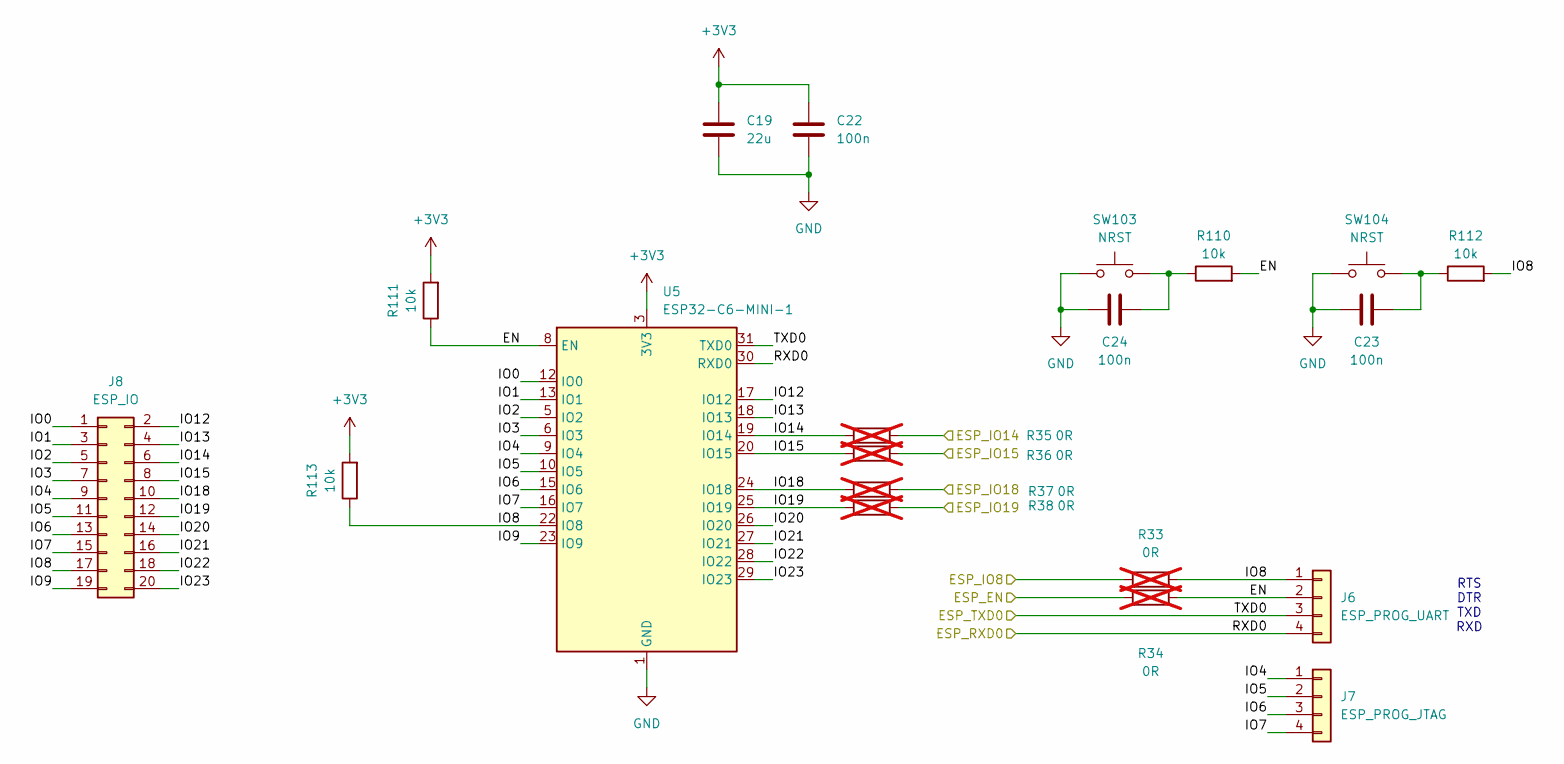
[picture p16: schematic esp32_c6_wireless_co_processor.kicad_sch]

Parts:
C19: 22u; C_0603_1608Metric; LCSC Part # C59461
C22, C23, C24: 100n; C_0402_1005Metric; LCSC Part # C1525
J6: ESP_PROG_UART; PinHeader_1x04_P1.27mm_Vertical
J7: ESP_PROG_JTAG; PinHeader_1x04_P1.27mm_Vertical
J8: ESP_IO; PinSocket_2x10_P1.27mm_Vertical_SMD
R33, R34, R35, R36, R37, R38: 0R; R_0402_1005Metric; LCSC Part # C17168; not fitted
R110, R111, R112, R113: 10k; R_0402_1005Metric; LCSC Part # C25744
SW103, SW104: NRST; SW_SPST_PTS810
U5: ESP32-C6-MINI-1

Connections:
+3V3: C19.1, C22.1, R111.2, R113.2, U5.3 (3V3); also elsewhere on the board
/ESP32-C6 Wireless Co-Processor/EN: J6.2, R34.2, R110.2, R111.1, U5.8 (EN)
/ESP32-C6 Wireless Co-Processor/IO0: J8.1, U5.12 (IO0)
/ESP32-C6 Wireless Co-Processor/IO1: J8.3, U5.13 (IO1)
/ESP32-C6 Wireless Co-Processor/IO2: J8.5, U5.5 (IO2)
/ESP32-C6 Wireless Co-Processor/IO3: J8.7, U5.6 (IO3)
/ESP32-C6 Wireless Co-Processor/IO4: J7.1, J8.9, U5.9 (IO4)
/ESP32-C6 Wireless Co-Processor/IO5: J7.2, J8.11, U5.10 (IO5)
/ESP32-C6 Wireless Co-Processor/IO6: J7.3, J8.13, U5.15 (IO6)
/ESP32-C6 Wireless Co-Processor/IO7: J7.4, J8.15, U5.16 (IO7)
/ESP32-C6 Wireless Co-Processor/IO8: J6.1, J8.17, R33.2, R112.2, R113.1, U5.22 (IO8)
/ESP32-C6 Wireless Co-Processor/IO9: J8.19, U5.23 (IO9)
/ESP32-C6 Wireless Co-Processor/IO12: J8.2, U5.17 (IO12)
/ESP32-C6 Wireless Co-Processor/IO13: J8.4, U5.18 (IO13)
/ESP32-C6 Wireless Co-Processor/IO14: J8.6, R35.1, U5.19 (IO14)
/ESP32-C6 Wireless Co-Processor/IO15: J8.8, R36.1, U5.20 (IO15)
/ESP32-C6 Wireless Co-Processor/IO18: J8.10, R37.1, U5.24 (IO18)
/ESP32-C6 Wireless Co-Processor/IO19: J8.12, R38.1, U5.25 (IO19)
/ESP32-C6 Wireless Co-Processor/IO20: J8.14, U5.26 (IO20)
/ESP32-C6 Wireless Co-Processor/IO21: J8.16, U5.27 (IO21)
/ESP32-C6 Wireless Co-Processor/IO22: J8.18, U5.28 (IO22)
/ESP32-C6 Wireless Co-Processor/IO23: J8.20, U5.29 (IO23)
/GPIO10: R33.1; also elsewhere on the board
/GPIO11: R34.1; also elsewhere on the board
/GPIO12: J6.4, U5.30 (RXD0); also elsewhere on the board
/GPIO13: J6.3, U5.31 (TXD0); also elsewhere on the board
/GPIO19: R35.2; also elsewhere on the board
/GPIO20: R36.2; also elsewhere on the board
/GPIO21: R37.2; also elsewhere on the board
/GPIO22: R38.2; also elsewhere on the board
GND: C19.2, C22.2, C23.2, C24.2, SW103.1, SW104.1, U5.1 (GND), U5.2 (GND), U5.11 (GND), U5.14 (GND), U5.36 (GND), U5.37 (GND), U5.38 (GND), U5.39 (GND), U5.40 (GND), U5.41 (GND), U5.42 (GND), U5.43 (GND), U5.44 (GND), U5.45 (GND), U5.46 (GND), U5.47 (GND), U5.48 (GND), U5.49 (GND), U5.50 (GND), U5.51 (GND), U5.52 (GND), U5.53 (GND); also elsewhere on the board
unnamed: C23.1, R112.1, SW104.2
unnamed: C24.1, R110.1, SW103.2

Notes on the sheet:
RTS DTR TXD RXD

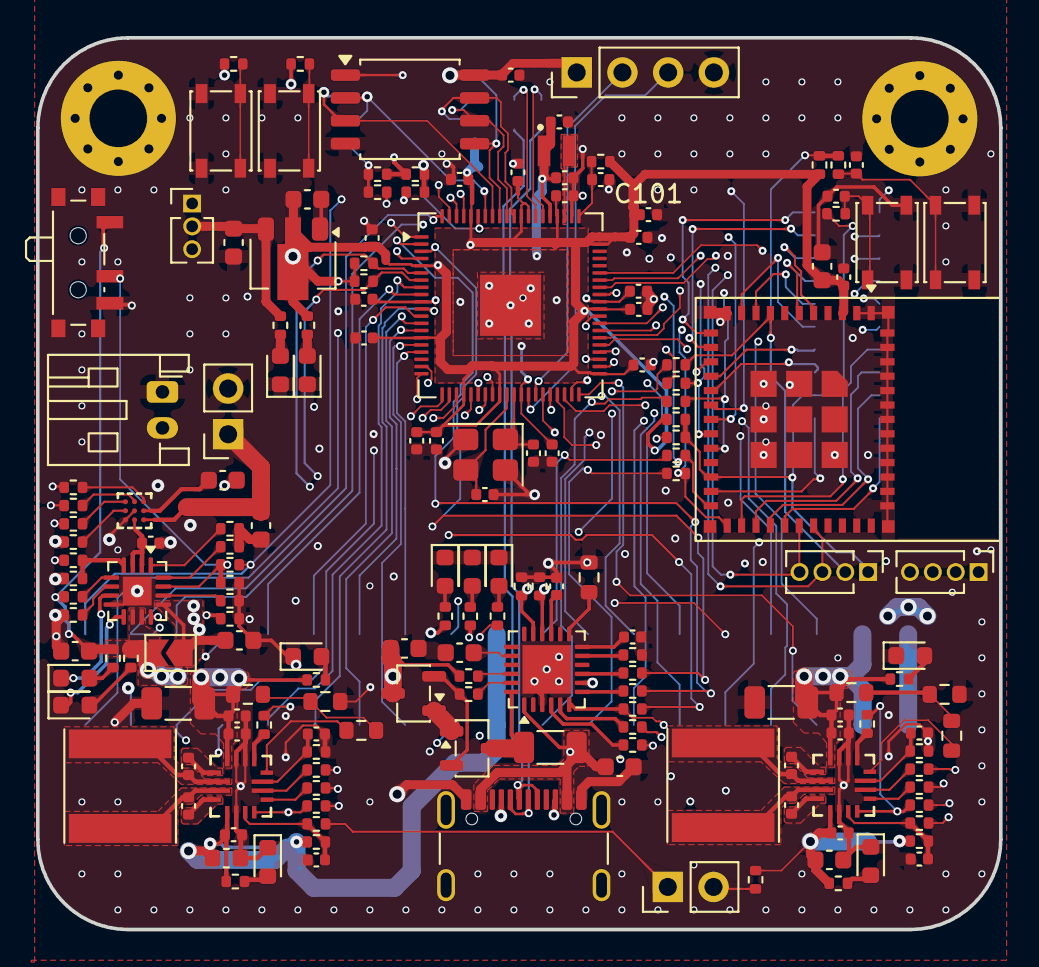
[picture p17: board ControlCardRP.kicad_pcb from above]

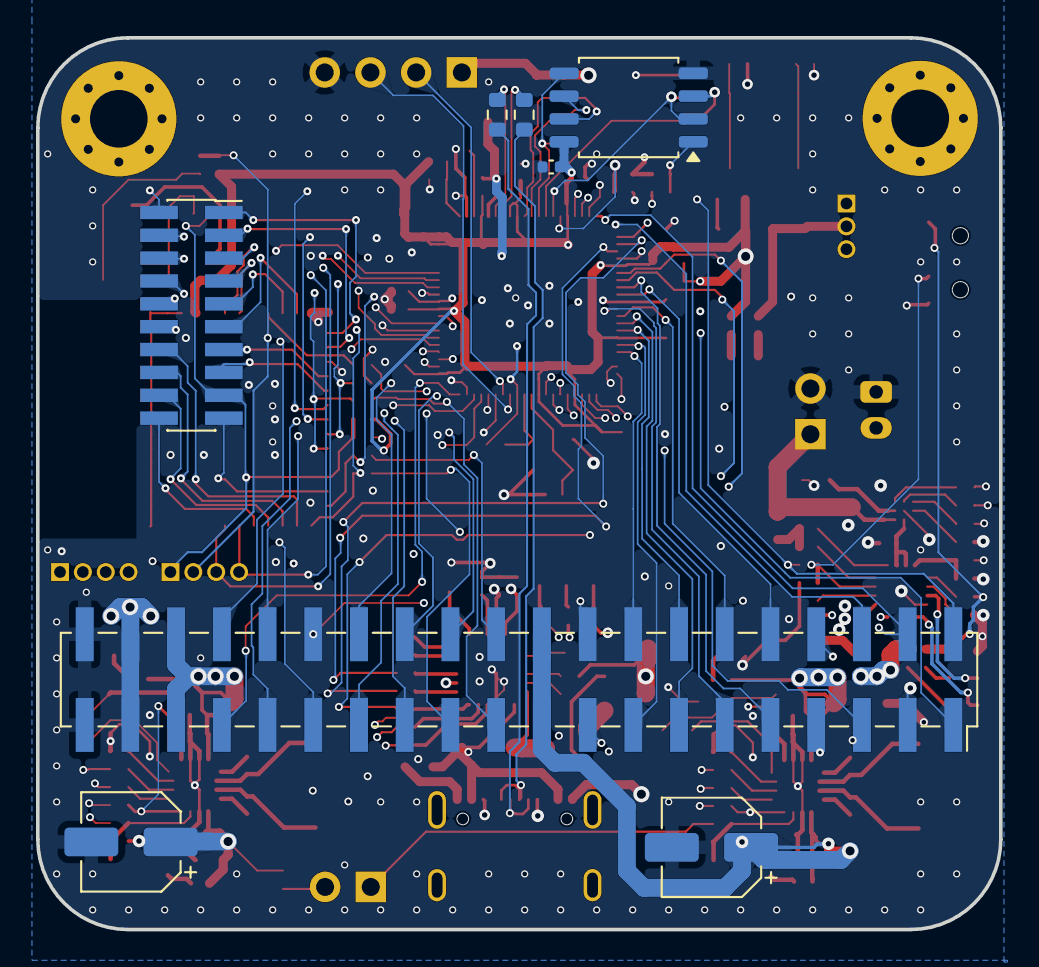
[picture p18: board ControlCardRP.kicad_pcb from below]

Board: 4 copper layers, 53.5 x 49.5 mm, 181 parts (8 on the bottom side), 169 nets.
