abinash18/KBUltra/(commit log)

2026-05-17 Added switches and finished initial layout with leds and stabalizers
    [KBUltraMk1.kicad_pcb, KBUltraMk1.kicad_sch, key_matrix.kicad_sch, lighting.kicad_sch]
2026-05-18 Added RP MCU
    [KBUltraMk1.kicad_pcb, KBUltraMk1.kicad_sch, accelerometer.kicad_sch, controller.kicad_sch, encoder.kicad_sch, extras.kicad_sch, haptic.kicad_sch, key_matrix.kicad_sch]
